breadboardinglabs/Breadboard8088PC/Docs/Datasheets/Video/IBM_PC_Original_Monochrome_Display_and_Parallel_Printer_Adapter.jpg

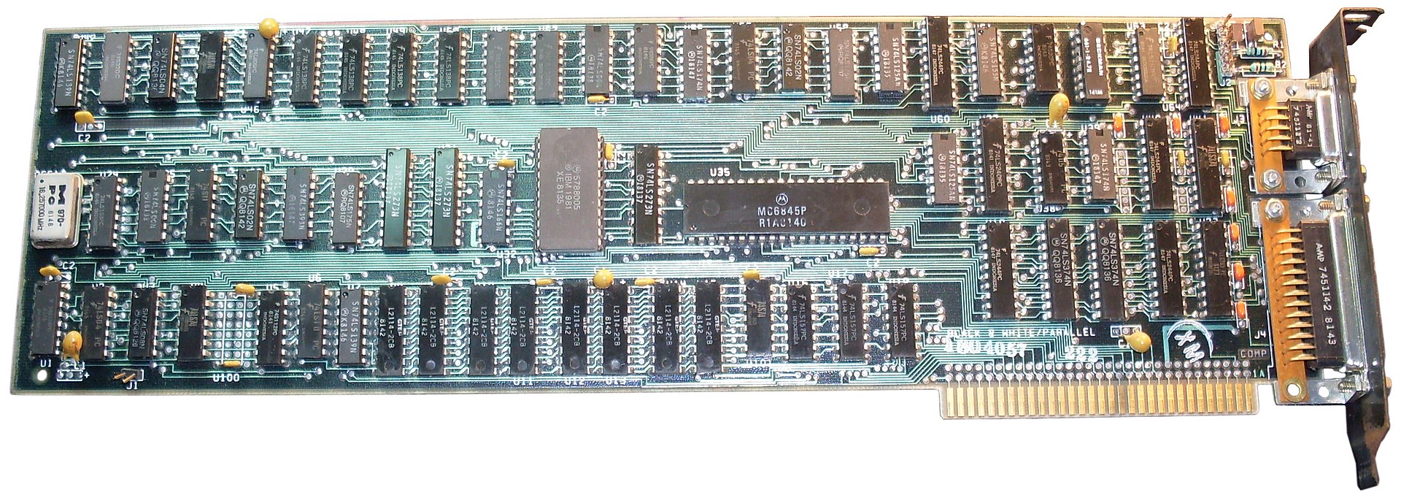
Docs/Datasheets/Video/IBM_PC_Original_Monochrome_Display_and_Parallel_Printer_Adapter.jpg
