breadboardinglabs/Breadboard8088PC/README.md

# Breadboard8088PC
IBM PC-XT Hybrid PC built on Breadboards
KiCad V2 for Breadboard PC now KiCad V8
Work in progress
