breadboardinglabs/Breadboard8088PC/Chiplabels/bbpc8088_p1v5.pdf

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
1̅C̅l̅r
1J
1̅K̅
1Clk
1̅P̅r̅e
1Q
1̅Q̅
GND

Vcc
2̅C̅l̅r
2J
2̅K̅
2Clk
2̅P̅r̅e
2Q
2̅Q̅

7
4
L
S
1
0
9

1̅C̅l̅r
1J
1̅K̅
1Clk
1̅P̅r̅e
1Q
1̅Q̅
GND

Vcc
2̅C̅l̅r
2J
2̅K̅
2Clk
2̅P̅r̅e
2Q
2̅Q̅

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
IRQA
IRQB
RS0
RS1
̅R̅E̅S̅E̅T
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
R/̅w̅

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
IRQA
IRQB
RS0
RS1
̅R̅E̅S̅E̅T
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
R/̅w̅

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
̅N̅M̅I̅
̅I̅R̅Q̅
̅F̅I̅R̅Q̅
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
H̅A̅L̅T̅
TSC
LIC
̅R̅E̅S̅E̅T
AVMA
Q
E
BUSY
R/̅W̅
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
C̅S̅
A10
PD/PGM
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
̅W̅E̅
A13
A8
A9
A11
̅O̅E̅
A10
̅C̅E̅
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
E (F)
F (E)
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
I/O0
I/O1
I/O2
Vss

Vcc
̅W̅E̅
A13
A8
A9
A11
̅O̅E̅
A10
̅C̅E̅
I/O7
I/O6
I/O5
I/O4
I/O3

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
R̅E̅S̅E̅T̅
LPSTB
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
MA10
MA11
MA12
MA13
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
̅C̅S̅
RS
E
R/̅W̅
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
I/O0
I/O1
I/O2
I/O3
I/O4
I/O5
VCC
I/O17
I/O16
I/O15
I/O14
I/O13
I/O12
In17
In18
In19
In20

In40
In39
In38
In37
I/O6
I/O7
I/O8
I/O9
I/O10
I/O11
GND
I/O23
I/O22
I/O21
I/O20
I/O19
I/O18
In23
In22
In21

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
DP 3
C 4
G 5
D4 6

12 D1
11 A
10 F
9 D2
8 D3
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
DP 3
C 4
G 5
D4 6

12 D1
11 A
10 F
9 D2
8 D3
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
P̅B̅R̅
TD
TOL
GND

Vcc
̅S̅T̅
̅R̅S̅T̅
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
̅G̅1̅
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
̅G̅2̅
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
̅G̅1̅
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
̅G̅2̅
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
̅G̅1̅
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
̅G̅2̅
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
̅G̅1̅
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
̅G̅2̅
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
CKI0
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
CKI0
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
II10
GND

Vcc
I/O0
I/O1
I/O2
I/O3
I/O4
I/O5
I/O6
I/O7
I/O8
I/O9
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
DCLK
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
̅Y̅0
̅Y̅1
̅Y̅2
̅Y̅3
̅Y̅4
̅Y̅5
Y0
̅Y̅7
vrw1
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
DCLK
SRO
CUR
DEIN
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
D̅E̅O
DE1
C̅L̅R
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
DCLK
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
DCLK
A0
NC
NC
NC
NC
VRW
R/W
̅Y̅0
Y0
DEin
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
D̅E̅O
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
̅1̅G̅
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
̅1̅G̅
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
̅1̅G̅
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
̅1̅G̅
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
8Vcc

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
25.175
MHz

1NC

GND

8Vcc

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
8Vcc

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
3.686
MHz

1NC

GND

8Vcc

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
1.843
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
C̅E̅L̅
R/̅W̅L̅
A11L
A10L
̅O̅E̅L̅
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
I/O0L
I/O1L
I/O2L
I/O3L
I/O4L
I/O5L
I/O6L
I/O7L
GND

Vcc
̅C̅E̅R̅
R/̅W̅R̅
A11R
A10R
̅O̅E̅R̅
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
I/O7R
I/O6R
I/O5R
I/O4R
I/O3R
I/O2R
I/O1R
I/O0R

I
D
T
7
1
3
4

C̅E̅L̅
R/̅W̅L̅
A11L
A10L
̅O̅E̅L̅
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
I/O0L
I/O1L
I/O2L
I/O3L
I/O4L
I/O5L
I/O6L
I/O7L
GND

Vcc
̅C̅E̅R̅
R/̅W̅R̅
A11R
A10R
̅O̅E̅R̅
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
I/O7R
I/O6R
I/O5R
I/O4R
I/O3R
I/O2R
I/O1R
I/O0R

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
I/O0
I/O1
I/O2
Vss

Vcc
̅W̅E
NC
A8
A9
A11
̅O̅E̅
A10
̅C̅E̅
I/O7
I/O6
I/O5
I/O4
I/O3

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
I/O0
I/O1
I/O2
Vss

Vcc
̅W̅E̅
A13
A8
A9
A11
̅O̅E̅
A10
̅C̅E̅
I/O7
I/O6
I/O5
I/O4
I/O3

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
̅W̅E̅
A13
A8
A9
A11
̅O̅E̅
A10
̅C̅E̅
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
̅W̅E̅
A13
A8
A9
A11
̅O̅E̅
A10
̅C̅E̅
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
I/O0
I/O1
I/O2
Vss

Vcc
̅W̅E
NC
A8
A9
A11
̅O̅E̅
A10
̅C̅E̅
I/O7
I/O6
I/O5
I/O4
I/O3

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
R0(1)
R0(2)

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
R0(1)
R0(2)

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
2I-2I+
1I-1I+

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
2I-2I+
1I-1I+

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
O̅C̅
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
O̅C̅
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
O̅C̅
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
̅G̅1̅
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
̅G̅2̅
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
̅G̅1̅
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
̅G̅2̅
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
̅G̅1̅
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
̅G̅2̅
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
̅G̅1̅
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
̅G̅2̅
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
Green
Blue
IRef
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
PCLK
Vss

Vdd
RS1
RS0
̅W̅R̅
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
̅B̅l̅a̅n̅k
̅R̅D̅

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
Green
Blue
IRef
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
PCLK
Vss

Vdd
RS1
RS0
̅W̅R̅
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
̅B̅l̅a̅n̅k
̅R̅D̅

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
G̅1̅E
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
G̅1̅E
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
G̅2̅E
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
G̅2̅E
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
C̅L̅R
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
C̅L̅R
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
QbCk
A0
MA12
GM1
GM0
PA1
VRW
R/W
̅Y̅0
Y0
DEin
GND

Vcc
̅G̅1̅E
̅G̅2̅E
DE1
CHR
̅H̅O̅E
̅H̅C̅E
̅O̅O̅E
COR
̅C̅C̅E
̅D̅E̅O
̅Y̅3̅C

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
QbCk
A0
MA13
GM1
GM0
PA1
VRW
R/W
̅Y̅0
Y0
DEin
GND

Vcc
̅G̅1̅E
̅G̅2̅E
DE1
CHR
̅H̅O̅E
̅H̅C̅E
̅O̅O̅E
COR
̅C̅C̅E
̅D̅E̅O
̅Y̅3̅C

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
̅O̅E̅

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
MA12
MA11
MA10
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
̅O̅E̅

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
̅O̅E̅

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
F/B̅

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
̅3̅I̅d̅e
R/̅W̅
NC
GND

Vcc
̅U̅d̅w
̅U̅d̅r
̅L̅d̅w
̅I̅o̅w
̅I̅o̅r
̅C̅S̅0
̅C̅S̅1
̅L̅d̅r
̅O̅E̅

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
̅ Q4
Q5
Q6
Q7
̅O̅E̅

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
CA13
CA12
CA11
CA10
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
̅O̅E̅

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
Edclk
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
mrdy
dc0
dc1
dc2
dc3
̅O̅E̅

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
DClk
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
!sY0
NC
NC
NC
NC
NC
̅O̅E̅

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
QbCk
A0
MA12
GM1
GM0
PA1
VRW
R/W
̅Y̅0
Y0
DEin
GND

Vcc
̅G̅1̅E
̅G̅2̅E
DE1
CHR
̅H̅O̅E
̅H̅C̅E
̅O̅O̅E
COR
̅C̅C̅E
̅D̅E̅O
̅Y̅3̅C

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
TEST0
XTAL1
XTAL2
̅R̅E̅S̅E̅T
THSS
CS
TLEA
RD
A0
WR
SYNC
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
TEST1
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
THSSP
THPR
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
IOB7
IOB6
IOB5
IOB4
IOB3
IOB2
IOB1
IOB0
IOA7
IOA6
IOA5
IOA4
IOA3
IOA2
IOA1

Vcc
TEST1
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
BDIR
TEST2
A8
̅A̅9̅
R̅E̅S̅E̅T
Clock
IOA0

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
ID10
ID11
ID12
ID13
ID14
ID15
KEY
GND
GND
GND
CSEL
GND
IOCS16
PDIAG
IA2
̅C̅S̅3̅F̅X
GND

I
D
E

1
3
9

R̅S̅T̅
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
DMARQ
̅I̅D̅W̅
̅I̅D̅R̅
IORDY
DMACK
IRQ
IA1
IA0
̅C̅S̅1̅F̅X
̅A̅C̅T̅I̅V̅E

In1
In2
In3
I/O0
I/O1
I/O2
I/O3
I/O4
I/O5
VCC
I/O17
I/O16
I/O15
I/O14
I/O13
I/O12
In17
In18
In19
In20

In40
In39
In38
In37
I/O6
I/O7
I/O8
I/O9
I/O10
I/O11
GND
I/O23
I/O22
I/O21
I/O20
I/O19
I/O18
In23
In22
In21

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
DotClk
E
R/W
Qa
Qb
Qc
Y0
I/O4
I/O5
VCC
I/O17
DC69
DC36
DC912
I/O13
I/O12
In17
In18
In19
In20

In40
In39
In38
In37
DCQ0
DCQ1
DCQ2
DCQ3
Y0
NotY0
GND
VRW
EQa
EQb
EQc
MRDY
I/O18
In23
In22
In21

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
# Nanocomp 6809 (for copying)
