breadboardinglabs/Breadboard8088PC/Chiplabels/bbpc8088v4.pdf

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
IRQA
IRQB
RS0
RS1
̅R̅E̅S̅E̅T
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
R/̅w̅

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
I/O0
I/O1
I/O2
Vss

Vcc
̅W̅E̅
A13
A8
A9
A11
̅O̅E̅
A10
̅C̅E̅
I/O7
I/O6
I/O5
I/O4
I/O3

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
CKI0
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
Out1
̅R̅s̅t
Spkr
Out2
I4
I5
I6
I7
I8
I9
̅T̅C̅
GND

Vcc
refd
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
̅R̅s̅t
̅I̅O̅R̅
̅I̅O̅W̅
I4
I5
̅L̅o̅c̅k
̅S̅0
̅S̅1
Hrq
Hold
GND

Vcc
̅D̅W̅
ABR
̅A̅E̅N
̅R̅D̅D
IO4
IO5
IO6
̅Rw1
Irwc
RD1
Rd̅w̅

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
I̅o̅1̅9
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
̅d̅p̅w̅
̅d̅m̅a
̅P̅i̅t
̅P̅i̅c̅1
̅P̅B̅r̅
̅P̅B̅w̅
̅P̅i̅c̅2
̅P̅o̅s̅t
̅I̅o̅w̅
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
8Vcc

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
3.686
MHz

C̅E̅L̅
R/̅W̅L̅
A11L
A10L
̅O̅E̅L̅
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
I/O0L
I/O1L
I/O2L
I/O3L
I/O4L
I/O5L
I/O6L
I/O7L
GND

Vcc
̅C̅E̅R̅
R/̅W̅R̅
A11R
A10R
̅O̅E̅R̅
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
I/O7R
I/O6R
I/O5R
I/O4R
I/O3R
I/O2R
I/O1R
I/O0R

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
̅W̅E̅
A13
A8
A9
A11
̅O̅E̅
A10
̅C̅E̅
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
I/O0
I/O1
I/O2
Vss

Vcc
̅W̅E
NC
A8
A9
A11
̅O̅E̅
A10
̅C̅E̅
I/O7
I/O6
I/O5
I/O4
I/O3

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
̅O̅E̅
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
̅O̅E̅
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
̅O̅E̅
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
̅G̅1̅
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
̅G̅2̅
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
̅G̅1̅
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
̅G̅2̅
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
Green
Blue
IRef
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
PCLK
Vss

Vdd
RS1
RS0
̅W̅R̅
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
̅B̅l̅a̅n̅k
̅R̅D̅

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
̅O̅E̅
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
M̅E̅M̅R̅
̅M̅E̅M̅W̅

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
̅I̅O̅R̅
̅I̅O̅W̅

E
̅R̅E̅S̅E̅T̅

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
INTR
CLK
GND

VCC
A15
A16S3
A17S4
A18S5
A19S6
HIGH
MN̅M̅X̅
̅R̅D̅
̅R̅Q̅G̅T̅0
̅R̅Q̅G̅T̅1
̅L̅O̅C̅K̅
̅S̅2̅
̅S̅1̅
̅S̅0̅
QS0
QS1
̅T̅E̅S̅T̅
READY
RESET

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
Csyc
Pclk
̅A̅e̅n̅1
Rdy1
Rdy
Rdy2
̅A̅e̅n̅2
CLK
GND

Vcc
X1
X2
̅A̅s̅y
EFI
F/̅C̅
Osc
̅R̅e̅s
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
̅S̅1̅
Dt/R̅
ALE
̅A̅E̅N
m̅r̅d
̅a̅m̅w
̅m̅wt
GND

Vcc
̅S̅0̅
̅S̅2̅
m̅p̅d
Den
Cen
̅I̅n̅t̅a
̅I̅o̅r̅c
̅A̅i̅ow
̅I̅o̅w

8
2
8
8

# Breadboard 8088 PC Ver 4.0

# Intel Chips

# 74 Series Logic Chips (0I indicate zero indexed)

# Memory Chips RAM & EEPROM

# PLD Programmable Logic Devices

# Other Chips and components

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
̅O̅E̅
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
̅O̅E̅
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
̅O̅E̅
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
P̅B̅R̅
TD
TOL
GND

Vcc
̅S̅T̅
̅R̅S̅T̅
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
8Vcc

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
1.843
MHz

1NC

GND

8Vcc

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
25.175
MHz

1NC

GND

8Vcc

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
8Vcc

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
14.3
MHz

̅I̅O̅R̅
̅I̅O̅W̅
̅M̅E̅M̅R
̅M̅EM̅w
Pin 5
Ready
HLDA
ADstb
AEN
HRQ
̅C̅S̅
CLK
RESET
Dack2
Dack3
Dreq3
Dreq2
Dreq1
Dreq0
GND

A7
A6
A5
A4
̅E̅O̅P̅
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
Dack0
Dack1
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
R̅E̅S̅E̅T̅
LPSTB
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
MA10
MA11
MA12
MA13
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
̅C̅S̅
RS
E
R/̅W̅
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
TEST0
XTAL1
XTAL2
̅R̅E̅S̅E̅T
THSS
CS
TLEA
RD
A0
WR
SYNC
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
TEST1
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
THSSP
THPR
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
̅W̅E̅
A13
A8
A9
A11
̅O̅E̅
A10
̅C̅E̅
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
̅W̅E̅
A13
A8
A9
A11
̅O̅E̅
A10
̅C̅E̅
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
̅W̅E̅
A13
A8
A9
A11
̅O̅E̅
A10
̅C̅E̅
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
̅R̅C̅L̅R̅
Vbat
̅I̅R̅Q̅
̅R̅E̅S̅E̅T̅
DS
GND
R/̅W̅
AS
̅C̅S̅

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
CLK0
OUT0
Gate0
GND

Vcc
̅W̅R̅
̅R̅D̅
̅C̅S̅
A1
A0
CLK2
OUT2
Gate2
CLK1
Gate1
OUT1

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
̅C̅S̅
̅W̅R̅
̅R̅D̅
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
CAS0
CAS1
GND

Vcc
A0
̅I̅N̅T̅A
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
̅S̅P/̅E̅N
CAS2

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
̅T̅x̅C̅
̅W̅R̅
̅C̅S̅
C/̅D̅
̅R̅D̅
RxRdy

D1
D0
Vcc
̅R̅x̅C
̅D̅T̅R
̅R̅T̅S
̅D̅S̅R
RESET
CLK
TxD
TxEmp
̅C̅T̅S
Syn/Bd
TxRdy

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
̅R̅D̅
̅C̅S̅
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
̅W̅R̅
RESET
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
̅M̅m̅r
̅M̅m̅w
DEN
GND

Vcc
IO0
IO1
IO2
̅C̅m̅0
̅P̅I̅A̅
̅R̅o̅m
̅R̅m̅1
E
̅R̅S̅T̅
̅D̅E̅N̅
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
DP 3
C 4
G 5
D4 6

12 D1
11 A
10 F
9 D2
8 D3
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
DP 3
C 4
G 5
D4 6

12 D1
11 A
10 F
9 D2
8 D3
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
VSin
HSin
InVS
InHS
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
̅O̅E̅

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
E (F)
F (E)
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
̅i̅o̅r
̅I̅o̅w̅
DEN
GND

Vcc
IO0
IOA
̅M̅d̅a
̅C̅m̅0
̅P̅I̅A̅
̅R̅o̅m
̅R̅m̅1
E
̅R̅S̅T̅
̅D̅E̅N̅
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
IO19
̅I̅O̅R
̅I̅O̅W̅
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
̅C̅r̅t̅s
̅6̅4̅5
̅C̅r̅t̅c
NC
̅P̅R̅D̅
̅P̅W̅R
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
25Mz
RA0
RA1
RA2
RA3
̅R̅S̅T
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
̅Q̅c̅
̅D̅o̅t
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
BlEn
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
Sdot
URA
BlEn
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
I0Clk
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
io19
io18
io17
io16
io15
io14
io13
io12
̅O̅E̅

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
PClk
Ck88
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
pitc
̅C̅L̅K̅
CLK
Clk3
Clk4
Clk5
̅R̅S̅T
̅O̅E̅

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
M̅R̅
Q0
̅Q̅0
D0
D1
̅Q̅1
Q1
GND

Vcc
Q3
̅Q̅3
D3
D2
̅Q̅2
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
̅M̅R
Hires
̅H̅i̅r̅e̅s
D0
D2
̅Q̅1
BW
GND

Vcc
EnBl
̅Q̅3
D5
D3
̅Q̅2
VEN
̅C̅r̅t̅c

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
̅G̅W̅
̅G̅R̅
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
25Mz
RA0
RA1
RA2
RA3
̅R̅S̅T
NC
NC
NC
NC
NC
GND

Vcc
Asrl
URA
VA0
CHL
Qa
Qb
CCc
̅Q̅c̅
vadl
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
M̅R̅
Q1
̅Q̅1
D1
D2
̅Q̅2
Q2
GND

Vcc
Q4
̅Q̅4
D4
D3
̅Q̅3
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
1̅C̅l̅r
1D
̅1̅C̅l̅k
̅1̅P̅R
1Q
̅1̅Q̅
GND

Vcc
̅2̅C̅l̅r
2D
̅2̅C̅l̅k
̅2̅P̅R̅
2Q
̅2̅Q̅

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
Irwc
IRD
̅R̅dw
Rd̅w̅
GND

Vcc
̅Hrq
RD1
̅C̅l̅k̅
̅2̅P̅R̅
Hold
̅2̅Q̅

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
BlEn
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
̅G̅/W

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
̅R̅D
̅W̅R̅
̅C̅S̅
A0
̅D̅A̅C̅K̅
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
̅L̅D̅O̅R̅
̅L̅D̅C̅R̅
RST
̅R̅D̅D̅

Vcc
̅I̅D̅X̅
̅T̅R̅0̅0̅
̅W̅P̅
̅R̅W̅C̅
̅H̅D̅L
̅M̅O̅2
̅M̅O̅1
̅D̅S̅2
VSS
̅D̅S̅1
̅S̅T̅E̅P
̅D̅I̅R̅C̅
̅W̅D̅
̅W̅E̅
̅H̅S̅
PCVAL
CLK1
DRV
CLK2

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
̅R̅s̅t
̅I̅O̅R̅
̅I̅O̅W̅
I4
I5
̅L̅o̅c̅k
̅S̅0
̅S̅1
Hrq
Hold
GND

Vcc
̅D̅W̅
ABR
̅A̅E̅N
̅R̅D̅D
AB1
Rdm
̅D̅e̅n̅
̅Rw1
Irwc
RD1
Rd̅w̅

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
Out1
̅R̅s̅t
Spkr
Out2
A0
A1
A2
I7
I8
̅F̅D̅C̅
̅T̅C̅
GND

Vcc
refd
IO1
IO2
IO3
IO4
̅L̅d̅c̅r
̅L̅d̅o̅r
̅F̅d̅c̅s
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
IO19
̅I̅O̅R
̅I̅O̅W̅
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
̅C̅r̅t̅s
̅6̅4̅5
̅C̅r̅t̅c
̅F̅D̅C̅
̅P̅R̅D̅
̅P̅W̅R
̅K̅e̅y̅
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
