breadboardinglabs/Breadboard8088PC/Chiplabels/bbpc8088v6_pg2.pdf

# Breadboard 8088 PC Ver 6.0

# CGA PLD Programmable Logic Devices

# CGA Snow Programmable Logic Devices

## Main IO Decoder V4

## CGA IO Decoder U69 V4

## CGA Blink Clock U58 V1

## CGA Logic PLD1 U82 V1

## CGA Logic PLD1 U82 V2

## CGA Logic PLD2 U81 V2

## CRTC ADD MUX 2 U76 V1 CGA COL MUX U59 V1

## CGA ATT Latch MUX U64 V1

## CGA Video Out U60 V1

CGA Clock U63 V1 | CGA Clock U63 V2
| 40 Column Mode

## CRTC ADD MUX 1 U77 V1

Id3
VS 14
HS 13
Id1
Id0
GndV
+5V 9
GndB
GndG
GndR
GndH
Id2 4
Blue 3
Green
Red 1

Id3
VS 14
HS 13
Id1
Id0
GndV
+5V 9
GndB
GndG
GndR
GndH
Id2 4
Blue 3
Green
Red 1

CKI0
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
Hires
NC
NC
NC
̅R̅S̅T
NC
NC
NC
NC
NC
GND

Vcc
AtSr
NC
̅CAt
ChL
Qa
Qb
Qc
Ccc
Cad
Dclk
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
Hires
640B
NC
NC
̅R̅S̅T
NC
NC
NC
NC
NC
GND

Vcc
AtSr
Qd
̅CAt
ChL
Qa
Qb
Qc
Ccc
Cad
Dclk
Grph

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
EnBl
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
AlDt
GND

Vcc
Grph
AT7
̅C̅S̅R
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
ColS
CBI
C0
C1
I
R
G
B
640B
NC
Grph
GND

Vcc
CRB
CRG
CRR
C1z
AlDt
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
VSin
HSin
InVS
InHS
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
̅O̅E̅

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
̅Io̅r
̅I̅o̅w̅
DEN
GND

Vcc
̅C̅g̅a̅
̅I̅O̅A̅
̅M̅d̅a
̅C̅m̅0
̅P̅I̅A̅
̅R̅o̅m
̅R̅m̅1
E
NC
̅D̅E̅N̅
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
## Main IO Decoder V5

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
̅Io̅r
̅I̅o̅w̅
DEN
GND

Vcc
̅C̅g̅a̅
̅I̅O̅A̅
̅M̅d̅a
̅C̅m̅0
̅P̅I̅A̅
̅R̅o̅m
̅R̅m̅1
E
ALE
̅D̅E̅N̅
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
BlEn
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
Sdot
B/̅D̅E
BlEn
NC
NC
̅R̅S̅T
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
Bd̅1̅
Cgt
̅C̅S̅R
AlDt
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
I0Clk
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
io19
io18
io17
io16
io15
io14
io13
io12
̅O̅E̅

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
Grph
Ma12
Ma11
Ma10
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
̅O̅E̅

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
C̅h̅At
Grph
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
̅O̅E̅

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
C̅r̅a̅m
̅C̅I̅O̅
̅I̅O̅R̅
̅I̅O̅W̅
̅M̅m̅r
̅M̅m̅W
NC
NC
640b
GND

Vcc
NC
̅A̅O̅E
̅A̅L̅E
̅V̅O̅E
̅6̅4̅o
̅C̅O̅E
DIR
̅2̅C̅E̅
̅O̅E̅

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
̅C̅I̅O̅
̅I̅O̅R̅
̅I̅O̅W̅
̅M̅m̅r
̅M̅m̅W
C̅r̅a̅m
NC
640b
GND

Vcc
NC
̅A̅O̅E
̅A̅L̅E
̅V̅O̅E
̅6̅4̅o
̅C̅O̅E
DIR
̅2̅C̅E̅
̅O̅E̅

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
̅6̅4̅oe
SBA
CBA
CAB
SAB
DIR
̅V̅r̅w
̅V̅r̅o̅e
̅O̅E̅

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
̅I̅O̅W
̅I̅O̅R
̅M̅m̅w
̅M̅m̅r
̅C̅r̅a̅m
GND

## CGA Logic PLD2 U81 V1

Vcc
̅O̅E
SBA
CBA
CAB
SAB
DIR
̅V̅r̅w
̅V̅r̅o̅e
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
̅I̅O̅W
̅I̅O̅R
̅M̅m̅w
̅M̅m̅r
̅C̅r̅a̅m
GND

## CGA Logic PLD2 U81 V5

Vcc
Asw
Cad
Rad
Clk2
Awe
CAB
Rda
Cat
Rw
Rw1
Grph

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
Hires
DClk
NC
̅M̅m̅w
̅M̅m̅r
̅C̅r̅a̅m
GND

## CGA Logic PLD3 U84 V2

Vcc
Dird
ACK
̅A̅do̅e
̅V̅o̅e
CBA
Cad
̅6̅4̅oe
DIR
̅V̅r̅w
̅V̅r̅o̅e
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
Cabd
Awe
̅M̅m̅w
̅M̅m̅r
̅C̅r̅a̅m
GND

IO19
̅I̅O̅R
̅I̅O̅W̅
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
̅C̅s̅t̅a
̅6̅4̅5
̅C̅c̅t̅l
̅C̅c̅o̅l
̅P̅R̅D̅
̅P̅W̅R
̅C̅I̅O̅
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
̅O̅E̅
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
̅O̅E̅
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
74ALS573 0 Index Rev. | 74ALS541 0 Index Rev. | 74ALS574 0 Index Rev. | 74ALS174 0 Index

̅G̅1̅
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
̅G̅2̅
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
̅G̅1̅
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
̅G̅2̅
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
̅O̅E̅
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
̅O̅E̅
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
̅O̅E̅
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
M̅R̅
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
M̅R̅
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
## CGA Logic PLD1 U82 V3

NC
̅C̅I̅O̅
̅I̅O̅R̅
̅I̅O̅W̅
̅M̅m̅r
̅M̅m̅W
C̅r̅a̅m
NC
640b
GND

Vcc
NC
NC
NC
NC
̅6̅4̅o
̅C̅O̅E
DIR
̅2̅C̅E̅
̅O̅E̅

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
## CGA Logic PLD2 U81 V11

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
̅V̅r̅o̅e
̅V̅a̅o̅e
̅6̅4̅o̅e
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
DClk
̅V̅r̅w̅e
̅A̅d̅o̅e
̅M̅m̅w
̅M̅m̅r
̅C̅r̅a̅m
GND

## CGA Logic PLD3 U84 V13

Vcc
Dc0
Dc1
CAB
̅C̅B̅A
̅A̅d̅o
̅V̅r̅w
Rdw
ACk
Dc2
Dc3
̅C̅r̅m

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
640b
Hires
Grph
Dir
Cas1
NC
̅M̅m̅r
GND

CKI0
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
xnor
xor
nor
or
nand
and
invb
inva
̅O̅E̅

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
CKI0
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
̅R̅D̅
̅W̅R̅
MI̅O̅
Rdy
̅A̅e̅n
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
̅C̅8̅8
̅M̅W̅
̅M̅R̅
̅I̅O̅W̅
̅I̅O̅R̅
Pclk
̅R̅s̅t
Rst
̅R̅E̅S

A
T
F
7
5
0
C
