breadboardinglabs/Breadboard8088PC/Docs/MDA_PLD_Design.xlsx

Sheet: Sheet1
MDA PLD Configuration | Clock PLD | Video PLD | Attribute | Blink VS HS
Inputs
CRTC
Cursor +1/2 Char Clk |  | I
Disp En +1/2 Char Clk |  | I
RA0 | I
RA1 | I
RA2 | I
RA3 | I
VS (+ve 70Hz) |  |  |  | I
HS (-ve 70Hz) |  |  |  | I
DotClock | I
/Reset | I | I
Attribute 0-7 (Blink/BI, BR, BG, BB, FI, FR, FG, FB) Underline 001 |  |  | I8
Control Port
Blink Enable |  | I
Video Enable |  | I
BW/Colour |  |  | I
Blink Clock
 |  | I
Outputs
VS |  |  |  | O
/HS |  |  |  | O
Blink Clock (VS/32) |  |  |  | O5
DotClk Buff | O
/DotClk | O
Qa | O
Qb | O
Qc Char Clk | O
/Qc Char Clk | O
Char Latch | O
SR Latch | O
Underline RA | O | I
Underline 001 |  | I | O
Video
Video B/W (Fore/Back) |  | O | I
Video Intensity |  | O
I |  |  | O
Red |  |  | O
Green |  |  | O
Blue |  |  | O
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
