breadboardinglabs/Breadboard8088PC/Docs/MappingDA_Combined_CGA.xlsx

Sheet: SNOW V2
CPU Start Activity Dot Clock Cycle | CAB ADCLK Start | CAB ADCLK End | OE Start | OE End | VRWE /CBA Start/End | Group
C0/4 | 2 | 2 | 4 | 5.5 | 5 | A
C1/5 | 2 | 2 | 3 | 4.5 | 4 | B | Mode 4 5-7.5
C2/6 | 2 | 2 | 6 | 7.5 | 7 | C
C3/7 | 2 | 2 | 4 | 5.5 | 5 | D
C4 | 3 | 3 | 5.5 | 7 | 6 | A
C5 | 3 | 3 | 4.5 | 6 | 5 | B
C6 | 3 | 3 | 7.5 | 9 | 8 | C
C7 | 3 | 3 | 6.5 | 8 | 7 | D
Count Dot Clock (DC) Cycles from MEMR/MEMW signal high to low transition (CPUACT CPU Activity) |  |  |  |  | NOTE | VRWE 1/2 Dot Clock Wide 20ns
Zero Dot Clock Cycle count when CPUACT=0 |  |  |  |  |  | OE End really means previous cycle 7 end all of 6!
 |  |  |  |  |  | OE Starts are on 2nd half of Dot Clock when low !DotClk
Qa,Qb,Qc CRTC clocks latched by rising CPUACT to CQa, CQb, CQc, CQd Clock=CPUACT, .d=Qa/Qb/Qc/Qd |  |  |  |  | OE | ADOE, VROE, VAOE, 646OE
DotClock Q0,Q1,Q2,Q3, clocked by CPUACT & Dot Clock (only clock when CPUACT high), cleared by CPUACT low |  |  |  |  |  | 646OE when reading is same period as MEMR

Sheet: SNOW V1
CPU Start Activity Dot Clock Cycle | CAB ADCLK Start | CAB ADCLK End | OE Start | OE End | VRWE /CBA Start/End | Group
C0 | 3 | 3 | 5.5 | 7 | 6 | A
C1 | 3 | 3 | 4.5 | 6 | 5 | B
C2 | 3 | 3 | 7.5 | 9 | 8 | C
C3 | 3 | 3 | 6.5 | 8 | 7 | D
C4 | 3 | 3 | 5.5 | 7 | 6 | A
C5 | 3 | 3 | 4.5 | 6 | 5 | B
C6 | 3 | 3 | 7.5 | 9 | 8 | C
C7 | 3 | 3 | 6.5 | 8 | 7 | D
Count Dot Clock (DC) Cycles from MEMR/MEMW signal high to low transition (CPUACT CPU Activity) |  |  |  |  | NOTE | VRWE 1/2 Dot Clock Wide 20ns
Zero Dot Clock Cycle count when CPUACT=0 |  |  |  |  |  | OE End really means previous cycle 7 end all of 6!
 |  |  |  |  |  | OE Starts are on 2nd half of Dot Clock when low !DotClk
Qa,Qb,Qc CRTC clocks latched by rising CPUACT to CQa, CQb, CQc, CQd Clock=CPUACT, .d=Qa/Qb/Qc/Qd |  |  |  |  | OE | ADOE, VROE, VAOE, 646OE
DotClock Q0,Q1,Q2,Q3, clocked by CPUACT & Dot Clock (only clock when CPUACT high), cleared by CPUACT low |  |  |  |  |  | 646OE when reading is same period as MEMR

Sheet: Sheet2
Dot Clock Cycle | Width | C0 Start | C0 End | C1 Start | C1 End | C2 Start | C2 End | C3 Start | C3 End | C4 Start | C4 End | C5 Start | C5 End | C6 Start | C6 End | C7 Start | C7 End
CharLatch | 36 | 0 | 0 | 8 | 8 | 8 | 8 | 8 | 8 | 8 | 8 | 8 | 8 | 8 | 8 | 0 | 0
AtSRLatch | 36 | 4 | 4 | 4 | 4 | 4 | 4 | 4 | 4 | C | C | 4 | 4 | C | C | 4 | 4
CAB | 68 | 3 | 4 | 3.5 | 5.5 | 4.5 | 6.5 | A | B | 7.5 | 9.5 | D.5 | F.5 | 9.5 | B.5 | 6 | 7
/CBA | 52 | A | A
646Dir | 32 | A | B | 12 | 12 | 12 | 12 | 12 | 12 | 12 | 12 | A.5 | B.5 | 12 | 12 | A | A
646OE | 26 | A | B | 12 | 12 | 12 | 12 | 12 | 12 | 12 | 12 | A.5 | B.5 | 12 | 12 | A | A
/VROE | 32 | A | B | 12 | 12 | 12 | 12 | 12 | 12 | 12 | 12 | A.5 | B.5 | 12 | 12 | A | A
VRWE | 16 | A | B | 12 | 12 | 12 | 12 | 12 | 12 | 12 | 12 | A.5 | B.5 | 12 | 12 | A | A
/VAOE | 30 | A | B | 12 | 12 | 12 | 12 | 12 | 12 | 12 | 12 | A.5 | B.5 | 12 | 12 | A | A
/ADOE | 26 | A | B | 12 | 12 | 12 | 12 | 12 | 12 | 12 | 12 | A.5 | B.5 | 12 | 12 | A | A
ADCLK | 66 | 3 | 4 | 4 | 5 | 5 | 6 | A.5 | B.5 | 7.5 | 9.5 | D.5 | F.5 | 9.5 | B.5 | 6 | 7

Sheet: CGA PLDS
 | CPU | CRTC | CPU | CRTC | CPU | CRTC
VRAM Address | Char | Char | 2 Colour | 2 Colour | 4 Colour | 4 Colour | Outputs | CGA PLD1 | Outputs | CGA PLD2
VA0 | CA0 | Qc | CA0 | MA0 | CA0 | MA0 | VA0 | Qc/ChAt | VA7 | MA6
VA1 | CA1 | MA0 | CA1 | MA1 | CA1 | MA1 | VA1 | MA0 | VA8 | MA7
VA2 | CA2 | MA1 | CA2 | MA2 | CA2 | MA2 | VA2 | MA1 | VA9 | MA8
VA3 | CA3 | MA2 | CA3 | MA3 | CA3 | MA3 | VA3 | MA2 | VA10 | MA9
VA4 | CA4 | MA3 | CA4 | MA4 | CA4 | MA4 | VA4 | MA3 | VA11 | MA10
VA5 | CA5 | MA4 | CA5 | MA5 | CA5 | MA5 | VA5 | MA4 | VA12 | MA11
VA6 | CA6 | MA5 | CA6 | MA6 | CA6 | MA6 | VA6 | MA5 | VA13 | MA12
VA7 | CA7 | MA6 | CA7 | MA7 | CA7 | MA7 |  | MA6 | VA14 | RA1
VA8 | CA8 | MA7 | CA8 | MA8 | CA8 | MA8 |  | GRPH |  | 0
VA9 | CA9 | MA8 | CA9 | MA9 | CA9 | MA9 |  | OE |  | GRPH | Video Mode/GRPH
VA10 | CA10 | MA9 | CA10 | MA10 | CA10 | MA10 |  |  |  | OE
VA11 | CA11 | MA10 | CA11 | MA11 | CA11 | MA11
VA12 | CA12 | MA11 | CA12 | MA12 | CA12 | MA12
VA13 | CA13 | MA12 | CA13 | RA1 | CA13 | RA1
VA14 | 0 | 0 | 0 | 0 | 0 | 0

Sheet: CGA 40x25
Clock Cycle 80ns | 0 | 0 | 1 | 1 | 2 | 2 | 3 | 3 | 4 | 4 | 5 | 5 | 6 | 6 | 7 | 7
Dot Clock | 1 | 0 | 1 | 0 | 1 | 0 | 1 | 0 | 1 | 0 | 1 | 0 | 1 | 0 | 1 | 0
Qb | 0 | 0 | 1 | 1 | 0 | 0 | 1 | 1 | 0 | 0 | 1 | 1 | 0 | 0 | 1 | 1
Qc | 0 | 0 | 0 | 0 | 1 | 1 | 1 | 1 | 0 | 0 | 0 | 0 | 1 | 1 | 1 | 1
Qd | 0 | 0 | 0 | 0 | 0 | 0 | 0 | 0 | 1 | 1 | 1 | 1 | 1 | 1 | 1 | 1
/Char Attribute VA0 current | 0 | 0 | 1 | 1 | 1 | 1 | 1 | 1 | 1 | 1 | 0 | 0 | 0 | 0 | 0 | 0
/Char Clock | 1 | 1 | 1 | 1 | 1 | 1 | 1 | 1 | 0 | 0 | 0 | 0 | 0 | 0 | 0 | 0
Required VA0 | 0 | 0 | 0 | 0 | 1 | 1 | 1 | 1 | 1 | 1 | 1 | 1 | 0 | 0 | 0 | 0
ChAt currently !Qd + 80ns, needs to be + 160ns |  |  | (Qb & !Qc & !Qd) |  | # (!Qb & Qc & !Qb) |  | #(Qb & Qc &!Qd) |  | #(!Qb & !Qc& Qd)
Address | 0F0 | F1 | F2 | F3 | F4 | F5 | F6 | F7 | F8 | F9
VA0 | 0 | 1 | 0 | 1 | 0 | 1 | 0 | 1 | 0 | 1
VA1 | 0 | 0 | 1 | 1 | 0 | 0 | 1 | 1 | 0 | 0
VA2 | 0 | 0 | 0 | 0 | 1 | 1 | 1 | 1 | 0 | 0
Real VA0
Real VA1 |  | 1
 | 0 | 4 | space | 0 | 8 | Symbol 1 | space | 0 | 9 | symbol 2
Attribute | 0F | 0F | 0F | 08 | 08 | 08 | 0F | 09 | 09 | 09
Observed | 0F | 08 | ? | 09 | 08 | 09 | 7 & 09 | 0A | 09 | 0A

Sheet: MCGA 640x480 x 2C
Video RAM 1 | CPU | CRTC | Video RAM 2 | CPU | CRTC | Character RAM 4K | CPU | CRTC |  | Page/Graphics Mode Register
Graphics1 |  |  | Graphics2 |  |  |  |  |  | Bit |  |  | Page 0 - 16K | Page 1 16-32K | Page 2 32-48K | Page 3 48-64K
V1A0 | CA0 | MA0 | V2A0 | CA0 | MA0 | CHA0 | CA0 | RA0 | 0 | PA0 | Page LSB | 0 | 1 | 0 | 1
V1A1 | CA1 | MA1 | V2A1 | CA1 | MA1 | CHA1 | CA1 | RA1 | 1 | PA1 | Page MSB | 0 | 0 | 1 | 1
V1A2 | CA2 | MA2 | V2A2 | CA2 | MA2 | CHA2 | CA2 | RA2
V1A3 | CA3 | MA3 | V2A3 | CA3 | MA3 | CHA3 | CA3 | RA3
V1A4 | CA4 | MA4 | V2A4 | CA4 | MA4 | CHA4 | CA4 | V1D0 | 2 | GM0 | 0=640x480 2 Colour, 1=320x200 256 Colour
V1A5 | CA5 | MA5 | V2A5 | CA5 | MA5 | CHA5 | CA5 | V1D1 | 3 | GM1 | Graphics=1 Character=0
V1A6 | CA6 | MA6 | V2A6 | CA6 | MA6 | CHA6 | CA6 | V1D2
V1A7 | CA7 | MA7 | V2A7 | CA7 | MA7 | CHA7 | CA7 | V1D3 | 4 | TBD | RAM or ROM Bank? |  | Block | CRTC Start | CRTC End | CPU Start | CPU End | Diff Start | Diff End
V1A8 | CA8 | MA8 | V2A8 | CA8 | MA8 | CHA8 | CA8 | V1D4 | 5 | TBD |  |  | 0 | 0 | 7999 | 0 | 7999
V1A9 | CA9 | MA9 | V2A9 | CA9 | MA9 | CHA9 | CA9 | V1D5 | 6 | TBD |  |  | 1 | 8192 | 16191 | 8000 | 15999 | 192 | 192
V1A10 | CA10 | MA10 | V2A10 | CA10 | MA10 | CHA10 | CA10 | V1D6 | 7 | TBD |  |  | 2 | 16384 | 24383 | 16000 | 23999 | 384 | 384
V1A11 | CA11 | MA11 | V2A11 | CA11 | MA11 | CHA11 | CA11 | V1D7 |  |  |  |  | 3 | 24576 | 32575 | 24000 | 31999 | 576 | 576
V1A12 | CA12 | MA12 | V2A12 | CA12 | MA12 | CE | 1 |  |  |  |  |  | 4 | 32768 | 40767 | 32000 | 39999 | 768 | 768
V1A13 | CA13 | RA0 | V2A13 | CA13 | RA0 | R/W | R/W |  |  |  |  |  | 5 | 40960 | 48959 | 40000 | 47999 | 960 | 960
V1A14 | CA14 | RA1 | V2A14 | CA14 | RA1 | CHD0 | D0 | SR_A |  |  |  |  | 6 | 49152 | 57151 | 48000 | 55999 | 1152 | 1152
1/OE (CHOE) | CA15 | RA2 | 2/OE (COOE) | CA15 | RA2 | CHD1 | D1 | SR_B |  |  |  |  | 7 | 57344 | 65343 | 56000 | 63999 | 1344 | 1344
CHR/W |  | 1 | COR/W |  | 1 | CHD2 | D2 | SR_C
V1D0 | D0 | SR_A | V2D0 | D0 | SR_A | CHD3 | D3 | SR_D
V1D1 | D1 | SR_B | V2D1 | D1 | SR_B | CHD4 | D4 | SR_E
V1D2 | D2 | SR_C | V2D2 | D2 | SR_C | CHD5 | D5 | SR_F |  |  |  |  |  |  | EEProM 8 bits |  | 64 - 6 bits
V1D3 | D3 | SR_D | V2D3 | D3 | SR_D | CHD6 | D6 | SR_G
V1D4 | D4 | SR_E | V2D4 | D4 | SR_E | CHD7 | D7 | SR_H
V1D5 | D5 | SR_F | V2D5 | D5 | SR_F
V1D6 | D6 | SR_G | V2D6 | D6 | SR_G | Outputs from VRAM 1 & 2 Latched with new D Latch and joined to Shift Register Inputs SR_A-SR_H
V1D7 | D7 | SR_H | V2D7 | D7 | SR_H
V1A# | Video RAM 1 Address |  |  |  | VRAM 1 32K Used in 16K 8000-BFFF 16K RANGE, A13=CA13 & A14=PA0
V1D# | Video RAM 1 Data |  |  |  | VRAM 2 32K Used in 16K 8000-BFFF 16K RANGE, A13=CA13 & A14=PA0
V2A# | Video RAM 2 Address
V2D# | Video RAM 2 Data |  |  |  | CRTC 80 Cols X 120 Rows x 4 Lines Per Character
CHA# | Character RAM Address
CHD# | Character RAM Data
MA# | CRTC Memory Address
RA# | CRTC Row Address
SR_# | Shift Register Data
CA# | CPU Address
D# | CPU Data
CL# | Colour Latch
PA# | Page Address

Sheet: CGA VRWE
CLK88 | 1 | 0 | 1 | 0 | 1 | 0 | 1 | 0 | 1 | 0 | 1 | 0 | 1 | 0
!CLK88 | 0 | 1 | 0 | 1 | 0 | 1 | 0 | 1 | 0 | 1 | 0 | 1 | 0 | 1
CGARAM | 0 | 0 | 1 | 1 | 1 | 1 | 1 | 1 | 0 | 0 | 0 | 0 | 0 | 0
MEMW | 0 | 0 | 0 | 1 | 1 | 1 | 1 | 0 | 0 | 0 | 0 | 0 | 0 | 0
MEMW & CGARAM | 0 | 0 | 0 | 1 | 1 | 1 | 1 | 0 | 0 | 0 | 0 | 0 | 0 | 0
VRWEDELAY | 0 | 0 | 0 | 0 | 0 | 1 | 1 | 1 | 1 | 0 | 0 | 0 | 0 | 0
VRWE=VRWEDELAY & MEMW & CLK88 | 0 | 0 | 0 | 0 | 0 | 1 | 1 | 0 | 0 | 0 | 0 | 0 | 0 | 0

Sheet: COMBINED PLD
Inputs | Outputs | Rules
NANOCOMPV11.PLD | Nanocomp Address Decoder
Pin 1 = DotClk; | Pin 23 = !Y0VRAM; /* Video RAM Low */ | Y0VRAM = (A15 & !A14) & E;
Pin 2 = RW; | Pin 22 = !Y1RAM; /* RAM /CS */ | Y1RAM = !A15 & E;
Pin 3 = A15; | Pin 21 = !Y2CRAM; /* Video Character RAM */ | Y2CRAM = A15 & A14 & !A13 & !A12 & E;
Pin 4 = A14; | Pin 20 = !Y3CRTC; /* CRTC */ | Y3CRTC = A15 & A14 & !A13 & A12 & !A11 & A10 & E; /* take out A8 and A9 conditions now that 74LS138 is used in place of Y6 */
Pin 5 = A13; | Pin 19 = !Y4PIA1; /* PIA MC6821 /CS */ | Y4PIA1 = A15 & A14 & !A13 & A12 & !A11 & !A10 & !A9 & !A8 & E;
Pin 6 = A12; | Pin 18 = !Y5SERIAL1; /* MC6850 /CS */ | Y5SERIAL1 = A15 & A14 & !A13 & A12 & !A11 & !A10 & A9 & !A8 & E;
Pin 7 = A11; | Pin 17 = Y0VRAMH; /* Video RAM High */ | Y0VRAMH = Y0VRAM;
Pin 8 = A10; | Pin 16 = !Y7ROM; /* ROM /CS */ | Y7ROM = A15 & A14 & A13 & E & RW;
Pin 9 = A9; | Pin 15 = VRAMRW1; /* Video RAM R/W shortened by Q&E */ | VRAMRW1.d = (RW # !Y0VRAMCE);
Pin 10 = A8; | Pin 14 = VRAMRW; /* Video RAM R/W ORd with !Y0VRAMCE */ | VRAMRW.d = VRAMRW1;
Pin 11 = Q;
Pin 13 = E; |  | Y0VRAMCE = (A15 & !A14) & E & Q;
VIDEOLOGIC1V12.PLD | Video Logic 1
Pin 1 = QbClk; | Pin 23 = !G1EN; /* Graphics Latch 1 Enable, sends VRAM data to Shift Reg */ | G1EN = (NOTY0 & !MA12 & (graphics_mode:2 # graphics_mode:3));
Pin 2 = A0; | Pin 22 = !G2EN; /* Graphics Latch 2 Enable, sends VRAM data to Shift Reg */ | G2EN = (NOTY0 & MA12 & (graphics_mode:2 # graphics_mode:3));
Pin 3 = MA12; | Pin 21 = DE1; /* Intermediate DE 1 clock delay, not used now */
Pin 4 = GM1; | Pin 20 = !CHRW; /* Character RAM Read/Write control */ | CHRW = ((!VRW & A0 & graphics_mode:0) # (!VRW & !PA1 & (graphics_mode:2 # graphics_mode:3)));
Pin 5 = GM0; | Pin 19 = !CHOE; /* Character RAM Output Enable control */ | CHOE = (((!CHRW # RW) & graphics_mode:0) # ((!(!VRW & !PA1) # (RW & !MA12)) & (graphics_mode:2 # graphics_mode:3)) );
Pin 6 = PA1; | Pin 18 = !CH245CE; /* Character 245 Buffer Chip Enable */ | CH245CE = ((Y0 & A0 & graphics_mode:0) # (Y0 & !PA1 & (graphics_mode:2 # graphics_mode:3)));
Pin 7 = VRW; | Pin 17 = !COOE; /* Colour RAM Output Enable control */ | COOE = (((!CORW # RW) & graphics_mode:0) # ((!(!VRW & PA1) # (RW & MA12)) & COLY3 & (graphics_mode:2 # graphics_mode:3)) );
Pin 8 = RW; | Pin 16 = !CORW; /* Colour RAM Read/Write control */ | CORW = ((!VRW & !A0 & graphics_mode:0) # (!VRW & PA1 & (graphics_mode:2 # graphics_mode:3)));
Pin 9 = NOTY0; | Pin 15 = !CO245CE; /* Colour 245 Buffer Chip Enable */ | CO245CE = ((Y0 & !A0 & graphics_mode:0) # (Y0 & PA1 & (graphics_mode:2 # graphics_mode:3)) # ( !COLY3 & graphics_mode:2));
Pin 10 = Y0; | Pin 14 = DEout; /* DE Inverted and delayed by 4 dot clock delays */ | DEout.d=!DEin;
Pin 11 = DEin;
Pin 13 = COLY3;
VIDEOLOGIC2V9.PLD | Video Logic 2
Pin 1 = DotClk; | Pin 23 = ForeBack; /* Video bit stream for foreground/background */ | ForeBack = Cur2 $ SRDotOut; /* Cursor delayed by 2 Dot Clocks XOR with Shift Register DotOut */
Pin 2 = SRDotOut; | Pin 22 = Cur1; /* Cursor delayed by 1 dot clock */ | Cur1.d = Cursor; /* Map Cursor to input of Cur1 Flip Flop */
Pin 3 = Cursor; | Pin 21 = Cur2; /* Cursor delayed by 2 dot clocks */ | Cur2.d = Cur1; /* Map Cur1 output to input of Cur2 Flip Flop to delay cursor by 2 dot clocks */
Pin 4 = NC0; | Pin 20 = CHLatch; /* Character Latch after 2 dot clock cycles */ | CHLatch=Qc # (!(Qa & Qb)); | Low to High 74LS574 trigger for latch
Pin 5 = NC1; | Pin 19 = Qa; /* Counter output /2 */ | Qa.d = !Qa;
Pin 6 = NC2; | Pin 18 = Qb; /* Counter outut /4 */ | Qb.d = (!Qb & Qa # Qb & !Qa);
Pin 7 = NC3; | Pin 17 = Qc; /* Counter output /8 */ | Qc.d = ((!Qc & Qb & Qa) # (Qc & !(Qb & Qa))) ;
Pin 8 = InvHS; | Pin 16 = SRLatch; /* Original /CLR delayed by 4 dot clock cycles */ | SRLatch= !(Qa & !Qb & Qc);
Pin 9 = InvVS; | Pin 15 = HSout; /* Horizontal Sync, inverted if InvHS is true */ | HSout=HSin&!InvHS # !HSin&InvHS;
Pin 10 = HSin; | Pin 14 = VSout; /* Vertical Sync, inverted if InvVS is true */ | VSout=VSin&!InvVS # !VSin&InvVS;
Pin 11 = VSin;
Pin 13 = NC4;
VRAM CRTC address 1
Pin 1 = MA6 | Pin 23 = VA6 | VA6 = (MA6 & (graphics_mode:0)) # (MA3 & (graphics_mode:2 # graphics_mode:3));
Pin 2 = MA5 | Pin 22 = VA5 | VA5 = (MA5 & (graphics_mode:0)) # (MA2 & (graphics_mode:2 # graphics_mode:3));
Pin 3 = MA4 | Pin 21 = VA4 | VA4 = (MA4 & (graphics_mode:0)) # (MA1 & (graphics_mode:2 # graphics_mode:3));
Pin 4 = MA3 | Pin 20 = VA3 | VA3 = (MA3 & (graphics_mode:0)) # (MA0 & (graphics_mode:2 # graphics_mode:3));
Pin 5 = MA2 | Pin 19 = VA2 | VA2 = (MA2 & (graphics_mode:0)) # (RA2 & (graphics_mode:2)) # (RA1 & (graphics_mode:3));
Pin 6 = MA1 | Pin 18 = VA1 | VA1 = (MA1 & (graphics_mode:0)) # (RA1 & (graphics_mode:2)) # (Qc & (graphics_mode:3));
Pin 7 = MA0 | Pin 17 = VA0 | VA0 = (MA1 & (graphics_mode:0)) # (RA0 & (graphics_mode:2)) # (Qb & (graphics_mode:3));
Pin 8 = RA2 | Pin 16 = Qb
Pin 9 = RA1 | Pin 15 = GM1 | [VA0..VA6].OE = !OEN; /* Outputs enabled when OE Low */
Pin 10 = RA0 | Pin 14 = GM0
Pin 11 = Qc |  | field graphics_mode = [GM1,GM0];
Pin 13 = OE
VRAM CRTC address 2
Pin 1 = MA12 | Pin 23 = VA14 | VA14 = (PA1 & (graphics_mode:0)) # (MA11 & (graphics_mode:2 # graphics_mode:3));
Pin 2 = MA11 | Pin 22 = VA13 | VA13 = (PA0 & (graphics_mode:0)) # (MA10 & (graphics_mode:2 # graphics_mode:3));
Pin 3 = MA10 | Pin 21 = VA12 | VA12 = (MA13 & (graphics_mode:0)) # (MA9 & (graphics_mode:2 # graphics_mode:3));
Pin 4 = MA9 | Pin 20 = VA11 | VA11 = (MA12 & (graphics_mode:0)) # (MA8 & (graphics_mode:2 # graphics_mode:3));
Pin 5 = MA8 | Pin 19 = VA10 | VA10 = (MA11 & (graphics_mode:0)) # (MA7 & (graphics_mode:2 # graphics_mode:3));
Pin 6 = MA7 | Pin 18 = VA9 | VA9 = (MA10 & (graphics_mode:0)) # (MA6 & (graphics_mode:2 # graphics_mode:3));
Pin 7 = MA6 | Pin 17 = VA8 | VA8 = (MA9 & (graphics_mode:0)) # (MA5 & (graphics_mode:2 # graphics_mode:3));
Pin 8 = MA5 | Pin 16 = VA7 | VA7 = (MA8 & (graphics_mode:0)) # (MA4 & (graphics_mode:2 # graphics_mode:3));
Pin 9 = MA4 | Pin 15 = GM1
Pin 10 = PA1 | Pin 14 = GM0 | [VA7..VA14].OE = !OEN; /* Outputs enabled when OE Low */
Pin 11 = PA0
Pin 13 = OE |  | field graphics_mode = [GM1,GM0];
VRAM CPU address 1 ATF16V8
Pin 1 = GM1 | Pin 19 = VA6 | VA6 = (CA7 & !GM1) # (CA6 & GM1);
Pin 2 = CA7 | Pin 18 = VA5 | VA5 = (CA6 & !GM1) # (CA5 & GM1);
Pin 3 = CA6 | Pin 17 = VA4 | VA4 = (CA5 & !GM1) # (CA4 & GM1);
Pin 4 = CA5 | Pin 16 = VA3 | VA3 = (CA4 & !GM1) # (CA3 & GM1);
Pin 5 = CA4 | Pin 15 = VA2 | VA2 = (CA3 & !GM1) # (CA2 & GM1);
Pin 6 = CA3 | Pin 14 = VA1 | VA1 = (CA2 & !GM1) # (CA1 & GM1);
Pin 7 = CA2 | Pin 13 = VA0 | VA0 = (CA1 & !GM1) # (CA0 & GM1);
Pin 8 = CA1 | Pin 12 = NC
Pin 9 = CA0 | Pin 11 = OEN | [VA0..VA6].OE= !OEN;
VRAM CPU address 2 ATF22V10
Pin 1 = PA1 | Pin 23 = VA14 | VA14 = (PA1 & !GM1) # (PA0 & GM1);
Pin 2 = PA0 | Pin 22 = VA13 | VA13 = (PA0 & !GM1) # (CA13 & GM1);
Pin 3 = CA13 | Pin 21 = VA12 | VA12 = (CA13 & !GM1) # (CA12 & GM1);
Pin 4 = CA12 | Pin 20 = VA11 | VA11 = (CA12 & !GM1) # (CA11 & GM1);
Pin 5 = CA11 | Pin 19 = VA10 | VA10 = (CA11 & !GM1) # (CA10 & GM1);
Pin 6 = CA10 | Pin 18 = VA9 | VA9 = (CA10 & !GM1) # (CA9 & GM1);
Pin 7 = CA09 | Pin 17 = VA8 | VA8 = (CA9 & !GM1) # (CA8 & GM1);
Pin 8 = CA08 | Pin 16 = VA7 | VA7 = (CA8 & !GM1) # (CA7 & GM1);
Pin 9 = CA07 | Pin 15 = NC
Pin 10 = GM1 | Pin 14 = NC
Pin 11 = NC
Pin 13 = OE |  | [VA7..VA14].OE= !OEN;
Additional for 256 colour
/DAC_WR
/DAC_RD
/DAC_CE
G2DACLATCH
G2DACOE |  | G1DACEN = (NOTY0 & !MA12 & graphics_mode:2);
G1DACLATCH
G1DACOE |  | G2DACEN = (NOTY0 & MA12 & graphics_mode:2);

Sheet: ORIGINAL PLD
Inputs | Outputs | Rules
NANOCOMPV11.PLD | Nanocomp Address Decoder
Pin 1 = DotClk; | Pin 23 = !Y0VRAM; /* Video RAM Low */ | Y0VRAM = (A15 & !A14) & E;
Pin 2 = RW; | Pin 22 = !Y1RAM; /* RAM /CS */ | Y1RAM = !A15 & E;
Pin 3 = A15; | Pin 21 = !Y2CRAM; /* Video Character RAM */ | Y2CRAM = A15 & A14 & !A13 & !A12 & E;
Pin 4 = A14; | Pin 20 = !Y3CRTC; /* CRTC */ | Y3CRTC = A15 & A14 & !A13 & A12 & !A11 & A10 & E; /* take out A8 and A9 conditions now that 74LS138 is used in place of Y6 */
Pin 5 = A13; | Pin 19 = !Y4PIA1; /* PIA MC6821 /CS */ | Y4PIA1 = A15 & A14 & !A13 & A12 & !A11 & !A10 & !A9 & !A8 & E;
Pin 6 = A12; | Pin 18 = !Y5SERIAL1; /* MC6850 /CS */ | Y5SERIAL1 = A15 & A14 & !A13 & A12 & !A11 & !A10 & A9 & !A8 & E;
Pin 7 = A11; | Pin 17 = Y0VRAMH; /* Video RAM High */ | Y0VRAMH = Y0VRAM;
Pin 8 = A10; | Pin 16 = !Y7ROM; /* ROM /CS */ | Y7ROM = A15 & A14 & A13 & E & RW;
Pin 9 = A9; | Pin 15 = VRAMRW1; /* Video RAM R/W shortened by Q&E */ | VRAMRW1.d = (RW # !Y0VRAMCE);
Pin 10 = A8; | Pin 14 = VRAMRW; /* Video RAM R/W ORd with !Y0VRAMCE */ | VRAMRW.d = VRAMRW1;
Pin 11 = Q;
Pin 13 = E; |  | Y0VRAMCE = (A15 & !A14) & E & Q;
VIDEOLOGIC1V11.PLD | Video Logic 1
Pin 1 = QbClk; | Pin 23 = !G1EN; /* Graphics Latch 1 Enable, sends VRAM data to Shift Reg */ | G1EN = (NOTY0 & !MA12 & graphics_mode:2);
Pin 2 = A0; | Pin 22 = !G2EN; /* Graphics Latch 2 Enable, sends VRAM data to Shift Reg */ | G2EN = (NOTY0 & MA12 & graphics_mode:2);
Pin 3 = MA12; | Pin 21 = DE1; /* Intermediate DE 1 clock delay, not used now */
Pin 4 = GM1; | Pin 20 = !CHRW; /* Character RAM Read/Write control */ | CHRW = ((!VRW & A0 & graphics_mode:0) # (!VRW & !PA1 & graphics_mode:2));
Pin 5 = GM0; | Pin 19 = !CHOE; /* Character RAM Output Enable control */ | CHOE = (((!CHRW # RW) & graphics_mode:0) # ((!(!VRW & !PA1) # (RW & !MA12)) & graphics_mode:2) );
Pin 6 = PA1; | Pin 18 = !CH245CE; /* Character 245 Buffer Chip Enable */ | CH245CE = ((Y0 & A0 & graphics_mode:0) # (Y0 & !PA1 & graphics_mode:2));
Pin 7 = VRW; | Pin 17 = !COOE; /* Colour RAM Output Enable control */ | COOE = (((!CORW # RW) & graphics_mode:0) # ((!(!VRW & PA1) # (RW & MA12)) & COLY3 & graphics_mode:2) );
Pin 8 = RW; | Pin 16 = !CORW; /* Colour RAM Read/Write control */ | CORW = ((!VRW & !A0 & graphics_mode:0) # (!VRW & PA1 & graphics_mode:2));
Pin 9 = NOTY0; | Pin 15 = !CO245CE; /* Colour 245 Buffer Chip Enable */ | CO245CE = ((Y0 & !A0 & graphics_mode:0) # (Y0 & PA1 & graphics_mode:2) # ( !COLY3 & graphics_mode:2));
Pin 10 = Y0; | Pin 14 = DEout; /* DE Inverted and delayed by 4 dot clock delays */ | DEout.d=!DEin;
Pin 11 = DEin;
Pin 13 = COLY3;
VIDEOLOGIC2V9.PLD | Video Logic 2
Pin 1 = DotClk; | Pin 23 = ForeBack; /* Video bit stream for foreground/background */ | ForeBack = Cur2 $ SRDotOut; /* Cursor delayed by 2 Dot Clocks XOR with Shift Register DotOut */
Pin 2 = SRDotOut; | Pin 22 = Cur1; /* Cursor delayed by 1 dot clock */ | Cur1.d = Cursor; /* Map Cursor to input of Cur1 Flip Flop */
Pin 3 = Cursor; | Pin 21 = Cur2; /* Cursor delayed by 2 dot clocks */ | Cur2.d = Cur1; /* Map Cur1 output to input of Cur2 Flip Flop to delay cursor by 2 dot clocks */
Pin 4 = NC0; | Pin 20 = CHLatch; /* Character Latch after 2 dot clock cycles */ | CHLatch=Qc # (!(Qa & Qb));
Pin 5 = NC1; | Pin 19 = Qa; /* Counter output /2 */ | Qa.d = !Qa;
Pin 6 = NC2; | Pin 18 = Qb; /* Counter outut /4 */ | Qb.d = (!Qb & Qa # Qb & !Qa);
Pin 7 = NC3; | Pin 17 = Qc; /* Counter output /8 */ | Qc.d = ((!Qc & Qb & Qa) # (Qc & !(Qb & Qa))) ;
Pin 8 = InvHS; | Pin 16 = SRLatch; /* Original /CLR delayed by 4 dot clock cycles */ | SRLatch= !(Qa & !Qb & Qc);
Pin 9 = InvVS; | Pin 15 = HSout; /* Horizontal Sync, inverted if InvHS is true */ | HSout=HSin&!InvHS # !HSin&InvHS;
Pin 10 = HSin; | Pin 14 = VSout; /* Vertical Sync, inverted if InvVS is true */ | VSout=VSin&!InvVS # !VSin&InvVS;
Pin 11 = VSin;
Pin 13 = NC4;

Sheet: Character MKII
Video RAM 1 | CPU | CRTC | Buffer | Video RAM 2 | CPU | CRTC |  | Character Generator | CPU | CRTC
Character 32K |  |  |  | Colour 32K |  |  |  | RAM 4K
V1A0 | CA1 | MA0 | A0 | V2A0 | CA1 | MA0 |  | CHA0 | CA0 | RA0
V1A1 | CA2 | MA1 | A1 | V2A1 | CA2 | MA1 |  | CHA1 | CA1 | RA1
V1A2 | CA3 | MA2 | A2 | V2A2 | CA3 | MA2 |  | CHA2 | CA2 | RA2
V1A3 | CA4 | MA3 | A3 | V2A3 | CA4 | MA3 |  | CHA3 | CA3 | RA3
V1A4 | CA5 | MA4 | A4 | V2A4 | CA5 | MA4 |  | CHLA4 | CA4 | V1D0
V1A5 | CA6 | MA5 | A5 | V2A5 | CA6 | MA5 |  | CHLA5 | CA5 | V1D1
V1A6 | CA7 | MA6 | A6 | V2A6 | CA7 | MA6 |  | CHLA6 | CA6 | V1D2
V1A7 | CA8 | MA7 | A7 | V2A7 | CA8 | MA7 |  | CHLA7 | CA7 | V1D3
V1A8 | CA9 | MA8 | A0 | V2A8 | CA9 | MA8 |  | CHLA8 | CA8 | V1D4
V1A9 | CA10 | MA9 | A1 | V2A9 | CA10 | MA9 |  | CHLA9 | CA9 | V1D5
V1A10 | CA11 | MA10 | A2 | V2A10 | CA11 | MA10 |  | CHLA10 | CA10 | V1D6
V1A11 | CA12 | MA11 | A3 | V2A11 | CA12 | MA11 |  | CHLA11 | CA11 | V1D7
V1A12 | CA13 | MA12 | A4 | V2A12 | CA13 | MA12 |  | CE | Y2
V1A13 | 0 | 0 | A5 | V2A13 | 0 | 0 |  | R/W | R/W | 1
V1A14 | 0 | 0 | A6 | V2A14 | 0 | 0 |  | CD0 | D0 | SR_A
1/OE (CHOE) | !(CHRW # RW) | !Y0 |  | 2/OE (COOE) | !(CORW # RW) | !Y0 |  | CD1 | D1 | SR_B
CHR/W | !(!VRW & A0) | 1 | A7 | COR/W | !(!VRW & !A0) | 1 |  | CD2 | D2 | SR_C
V1D0 | D0 | CHLA4 |  | V2D0 | D0 | CL0 |  | CD3 | D3 | SR_D
V1D1 | D1 | CHLA5 |  | V2D1 | D1 | CL1 |  | CD4 | D4 | SR_E
V1D2 | D2 | CHLA6 |  | V2D2 | D2 | CL2 |  | CD5 | D5 | SR_F
V1D3 | D3 | CHLA7 |  | V2D3 | D3 | CL3 |  | CD6 | D6 | SR_G
V1D4 | D4 | CHLA8 |  | V2D4 | D4 | CL4 |  | CD7 | D7 | SR_H
V1D5 | D5 | CHLA9 |  | V2D5 | D5 | CL5
V1D6 | D6 | CHAL10 |  | V2D6 | D6 | CL6
V1D7 | D7 | CHAL11 |  | V2D7 | D7 | CL7
VR/W | VideoRAM R/W |  |  |  |  | This is defined in NANOCOMP PLD as CPU R/W combined with VRAM CE Y0 & Q and delayed 2 Dot Clocks
V1A# | Video RAM 1 Address |  |  |  |  | VRAM 1 8K Used in 16K 8000-BFFF 16K RANGE, A13 & A14 wired low
V1D# | Video RAM 1 Data |  |  |  |  | VRAM 2 8K Used in 16K 8000-BFFF 16K RANGE, A13 & A14 wired low
V2A# | Video RAM 2 Address |  |  |  |  | In CPU Address space Colour Byte even, Character Byte Odd interleaved over 16K
V2D# | Video RAM 2 Data |  |  |  |  | CRTC Both VRAM use same MA address, 8K block 102 Lines using CRTC Memory offset
CHLA# | Character Latch RAM Address
CHA# | Character RAM Address
CHD# | Character RAM Data
MA# | CRTC Memory Address
RA# | CRTC Row Address
SR_# | Shift Register Data
CA# | CPU Address
D# | CPU Data
CL# | Colour Latch
 |  |  |  |  | Char RAM | Colour RAM | Ch245 /CE | Co245 /CE
 | CA0 | !CA0 | Y0 | !Y0 | 1/CE | 2/CE |  |  | 1/CE
 | 0 | 1 | 0 | 1 | 1 | 0 | 1 | 0 | 2/CE
 | 0 | 1 | 1 | 0 | 0 | 0 | 1 | 1
 | 1 | 0 | 0 | 1 | 0 | 1 | 0 | 1 | CH1CE= | !CA0 & !Y0
 | 1 | 0 | 1 | 0 | 0 | 0 | 1 | 1 | CO2CE= | CA0 & !Y0
 |  |  |  |  |  |  |  |  | CH245/CE | !(CA0&!Y0) | NAND (CA0,!Y0)
 |  |  |  |  |  |  |  |  | CO245/CE | !(!CA0&!Y0) | OR (CA0,Y0) = NAND(!CA0,!Y0)
 |  |  |  |  |  |  |  |  |  | All Enables are active LOW
 |  |  |  |  |  |  |  |  |  | Character RAM Enabled when Y=1 (CRTC) OR (Y=0 AND CA0=1) CPU Odd address
 |  |  |  |  |  |  |  |  |  | Colour RAM Enabled when Y=1 (CRTC) OR (Y=0 AND CA0=0) CPU Even Address
 |  |  |  |  |  |  |  |  |  | Character 245 Bi Di Buffer only enabled when (Y=0 AND CA0=1) CPU Odd Addresss
 |  |  |  |  |  |  |  |  |  | Colour 245 Bi Di Buffer only enabled when (Y=0 AND CA0=0) CPU Even Addresss
 |  |  |  |  |  |  |  |  |  | Alternatively Character RAM disabled for CPU Even addresses
 |  |  |  |  |  |  |  |  |  | Colour RAM disabled for CPU Odd Addresses
 |  |  |  |  |  |  |  |  |  | Character 245 disabled for CRTC and CPU Even addresses
 |  |  |  |  |  |  |  |  |  | Colour 245 disabled for CRTC and CPU Odd addresses

Sheet: Charactrer MKII Timing
Description | VR/W | /VR/W | CPU A0 | /CPU A0 | VRAM# R/W | Note VRW already ORed Y0 with R/W
Read/Write Character RAM VRAM #1 | 0 | 1 | 0 | 1 | 1 | VRW OR !A0 | Or !VRW NAND A0
 | 0 | 1 | 1 | 0 | 0
 | 1 | 0 | 0 | 1 | 1
 | 1 | 0 | 1 | 0 | 1
Read/Write Colour RAM VRAM #2 | 0 | 1 | 0 | 1 | 0 | VRW OR A0 | Or !VRW NAND !A0 | NAND | 0 | 0 | 1
 | 0 | 1 | 1 | 0 | 1 |  |  |  | 0 | 1 | 1
 | 1 | 0 | 0 | 1 | 1 |  |  |  | 1 | 0 | 1
 | 1 | 0 | 1 | 0 | 1 |  |  |  | 1 | 1 | 0
Also VRAM /OE needs to be high during writes so Bi Di Buffer and VRAM don't clash
 | CH245/CE | CPU R/W | CH VRAM /OE
Character VRAM | 0 | 0 | 1 |  | NOR (CH245/CE, CPU R/W)
 | 0 | 1 | 0
 | 1 | 0 | 0
 | 1 | 1 | 0
 | CO245/CE | CPU R/W | CO VRAM /OE
Colour VRAM | 0 | 0 | 1 |  | NOR (CO245/CE, CPU R/W)
 | 0 | 1 | 0
 | 1 | 0 | 0
 | 1 | 1 | 0

Sheet: 640x480 Pixel Map
Pixel Row | 16K Page | Column | 0-7 | 8-15 | 16-23 | 24-31 | 32-39 | 40-47 | … | 624-631 | 632-639
0 | 00 |  | 8000 | 8008 | 8010 | 8018 | 8020 | 8028 | … | 8270 | 8278 | 8 Pixel rows = 640 Bytes 0x280
1 | 00 |  | 8001 | 8009 | 8011 | 8019 | 8021 | 8029 | … | 8271 | 8279
2 | 00 |  | 8002 | 800A | 8012 | 801A | 8022 | 802A | … | 8272 | 827A
3 | 00 |  | 8003 | 800B | 8013 | 801B | 8023 | 802B | … | 8273 | 827B
4 | 00 |  | 8004 | 800C | 8014 | 801C | 8024 | 802C | … | 8274 | 827C
5 | 00 |  | 8005 | 800D | 8015 | 801D | 8025 | 802D | … | 8275 | 827D
6 | 00 |  | 8006 | 800E | 8016 | 801E | 8026 | 802E | … | 8276 | 827E
7 | 00 |  | 8007 | 800F | 8017 | 801F | 8027 | 802F | … | 8277 | 827F
8 | 00 |  | 8280 | 8288 | 8290 | 8298 | 82A0 | 82A8 | … | 84F0 | 84F8
9 | 00 |  | 8281 | 8289 | 8291 | 8299 | 82A1 | 82A9 | … | 84F1 | 84F9
10 | 00 |  | 8282 | 8290 | 8292 | 8300 | 82A2 | 82A10 | … | 84F2 | 84FA
11 | 00 |  | 8283 | 8291 | 8293 | 8301 | 82A3 | 82A11 | … | 84F3 | 84FB
12 | 00 |  | 8284 | 8292 | 8294 | 8302 | 82A4 | 82A12 | … | 84F4 | 84FC
13 | 00 |  | 8285 | 8293 | 8295 | 8303 | 82A5 | 82A13 | … | 84F5 | 84FD
14 | 00 |  | 8286 | 8294 | 8296 | 8304 | 82A6 | 82A14 | … | 84F6 | 84FE
15 | 00 |  | 8287 | 8295 | 8297 | 8305 | 82A7 | 82A15 | … | 84F7 | 84FF
… | 00 |  | 8500… |  |  |  | 48 | 49
 |  |  |  |  |  |  | 376-384 | 385-393
200 | 00/01 |  | BE80 | BE88 | BE90 | BE98 | BFF8 | 8000 |  | 80F0 | 80F8
201 | 00/01 |  | BE81 | BE89 | BE91 | BE99 | BFF9 | 8001 |  | 80F1 | 80F9
202 | 00/01 |  | BE82 | BE8A | BE92 | BE9A | BFFA | 8002 |  | 80F2 | 80FA
203 | 00/01 |  | BE83 | BE8B | BE93 | BE9B | BFFB | 8003 |  | 80F3 | 80FB
204 | 00/01 |  | BE84 | BE8C | BE94 | BE9C | BFFC | 8004 | … | 80F4 | 80FC
205 | 00/01 |  | BE85 | BE8D | BE95 | BE9D | BFFD | 8005 | … | 80F5 | 80FD
206 | 00/01 |  | BE86 | BE8E | BE96 | BE9E | BFFE | 8006 | … | 80F6 | 80FE
207 | 00/01 |  | BE87 | BE8F | BE97 | BE9F | BFFF | 8007 | … | 80F7 | 80FF
…
208 | 01 |  | 8100 | 8108 | 8110 | 8118 | …
 |  |  |  |  |  |  | 16 | 17
 |  |  |  |  |  |  | 120-128 | 129-137
408 | 01/10 |  | BF80 | BF88 | BFA0 | BFA8 | BFF8 | 8000 | … | 81F0 | 81F8
409 | 01/10 |  | BF81 | BF89 | BFA1 | BFA9 | BFF9 | 8001 | … | 81F1 | 81F9
410 | 01/10 |  | BF82 | BF9A | BFA2 | BFAA | BFFA | 8002 | … | 81F2 | 81FA
411 | 01/10 |  | BF83 | BF9B | BFA3 | BFAB | BFFB | 8003 | … | 81F3 | 81FB
412 | 01/10 |  | BF84 | BF9C | BFA4 | BFAC | BFFC | 8004 |  | 81F4 | 81FC
413 | 01/10 |  | BF85 | BF9D | BFA5 | BFAD | BFFD | 8005 |  | 81F5 | 81FD
414 | 01/10 |  | BF86 | BF9E | BFA6 | BFAE | BFFE | 8006 |  | 81F6 | 81FE
415 | 01/10 |  | BF87 | BF9F | BFA7 | BFAF | BFFF | 8007 |  | 81F7 | 81FF
416 | 10 |  | 8200 | 8208 | 8210 | 8218 | …
…
472 | 10 |  | 9380 | 9388 | 94F0 | 94F8 | 9500 | 9508 |  | 96F0 | 95F8
473 | 10 |  | 9381 | 9389 | 94F1 | 94F9 | 9501 | 9509 |  | 95F1 | 95F9
474 | 10 |  | 9382 | 938A | 94F2 | 94FA | 9502 | 950A |  | 95F2 | 95FA
475 | 10 |  | 9383 | 938B | 94F3 | 94FB | 9503 | 950B |  | 95F3 | 95FB
476 | 10 |  | 9384 | 938C | 94F4 | 94FC | 9504 | 950C |  | 95F4 | 95FC
477 | 10 |  | 9385 | 938D | 94F5 | 94FD | 9505 | 950D |  | 95F5 | 95FD
478 | 10 |  | 9386 | 938E | 94F6 | 94FE | 9506 | 950E |  | 95F6 | 95FE
479 | 10 |  | 9387 | 938F | 94F7 | 94FF | 9507 | 950F |  | 95F7 | 95FF
480 |  |  | 9600

Sheet: Graphics 320x200 x 256C & MDA
Video RAM 1 | CPU | CRTC | Video RAM 2 | CPU | CRTC |  | Character Cell 0 |  |  |  |  | Character Cell 1
Graphics1 |  |  | Graphics2 |  |  |  | Pixel | 0 | 1 | 2 | 3 |  | 0 | 1 | 2 | 3
V1A0 | CA0 | Qb | V2A0 | CA0 | Qb | RA1 |  | 0 | 0 | 0 | 0 |  | 0 | 0 | 0 | 0
V1A1 | CA1 | Qc | V2A1 | CA1 | Qc | DotClk/4 | Qb | 0 | 1 | 0 | 1 |  | 0 | 1 | 0 | 1
V1A2 | CA2 | RA1 | V2A2 | CA2 | RA1 | DotClk/8 | Qc | 0 | 0 | 1 | 1 |  | 0 | 0 | 1 | 1
V1A3 | CA3 | MA0 | V2A3 | CA3 | MA0
V1A4 | CA4 | MA1 | V2A4 | CA4 | MA1 | RA1 |  | 1 | 1 | 1 | 1 |  | 1 | 1 | 1 | 1
V1A5 | CA5 | MA2 | V2A5 | CA5 | MA2 | DotClk/4 | Qb | 0 | 1 | 0 | 1 |  | 0 | 1 | 0 | 1
V1A6 | CA6 | MA3 | V2A6 | CA6 | MA3 | DotClk/8 | Qc | 0 | 0 | 1 | 1 |  | 0 | 0 | 1 | 1
V1A7 | CA7 | MA4 | V2A7 | CA7 | MA4
V1A8 | CA8 | MA5 | V2A8 | CA8 | MA5 | 6845 CRTC Configuration 80 Characters & 100 Character Rows, 4 Raster Lines per Row
V1A9 | CA9 | MA6 | V2A9 | CA9 | MA6 |  | Same timing as 70 Hz 80x25 Character Mode
V1A10 | CA10 | MA7 | V2A10 | CA10 | MA7
V1A11 | CA11 | MA8 | V2A11 | CA11 | MA8 |  | Width 80 Characters x 4 pixels, 320 Pixels x 8 Bits, 256 Colours
V1A12 | CA12 | MA9 | V2A12 | CA12 | MA9 |  | Height 400 lines, ignore RA0 double scan, 200 lines, 100 Character Row
V1A13 | CA13 | MA10 | V2A13 | CA13 | MA10 | Clock Cycle | 0 | 0 | 1 | 1 | 2 | 2 | 3 | 3 | 4 | 4 | 5 | 5 | 6 | 6 | 7 | 7
V1A14 | PA0 | MA11 | V2A14 | PA0 | MA11 | Dot Clock | 1 | 0 | 1 | 0 | 1 | 0 | 1 | 0 | 1 | 0 | 1 | 0 | 1 | 0 | 1 | 0
1/CE | PA1=0 | MA12=0 | 2/CE | PA1=1 | MA12=1 | Qa | 0 | 0 | 1 | 1 | 0 | 0 | 1 | 1 | 0 | 0 | 1 | 1 | 0 | 0 | 1 | 1
R/W | R/W | 1 | R/W | R/W | 1 | Qb | 0 | 0 | 0 | 0 | 1 | 1 | 1 | 1 | 0 | 0 | 0 | 0 | 1 | 1 | 1 | 1
V1D0 | D0 | DAC0 | V2D0 | D0 | DAC0 | Qc | 0 | 0 | 0 | 0 | 0 | 0 | 0 | 0 | 1 | 1 | 1 | 1 | 1 | 1 | 1 | 1
V1D1 | D1 | DAC1 | V2D1 | D1 | DAC1 | CHLatch=Qc # (!(Qa & Qb)); | 1 | 1 | 1 | 1 | 1 | 1 | 0 | 0 | 1 | 1 | 1 | 1 | 1 | 1 | 1 | 1
V1D2 | D2 | DAC2 | V2D2 | D2 | DAC2 | SRLatch= !(Qa & !Qb & Qc); | 1 | 1 | 1 | 1 | 1 | 1 | 1 | 1 | 0 | 0 | 1 | 1 | 1 | 1 | 1 | 1
V1D3 | D3 | DAC3 | V2D3 | D3 | DAC3 | !Qa | 1 | 1 | 0 | 0 | 1 | 1 | 0 | 0 | 1 | 1 | 0 | 0 | 1 | 1 | 0 | 0
V1D4 | D4 | DAC4 | V2D4 | D4 | DAC4
V1D5 | D5 | DAC5 | V2D5 | D5 | DAC5 | G1/2 Latch=!(DC&Qa) | 1 | 1 | 0 | 1 | 1 | 0 | 1 | 1 | 1 | 0 | 1 | 1 | 1 | 0 | 1 | 1
V1D6 | D6 | DAC6 | V2D6 | D6 | DAC6 | ~~G1/2 Latch=(DC&!Qa)~~ | 0 | 1 | 0 | 0 | 0 | 1 | 1 | 0 | 1 | 1 | 1 | 0 | 1 | 1 | 1 | 0
V1D7 | D7 | DAC7 | V2D7 | D7 | DAC7
 |  |  |  |  |  | Latch triggered on 0 to 1 edge
V1A# | Video RAM 1 Address |  |  |  | VRAM 1 8K Used in 16K 8000-BFFF 16K RANGE, A13 & A14 wired low |  |  |  |  |  |  | CH Latch for MDA |  | CHLatch=Qc # Qa # Qb;
V1D# | Video RAM 1 Data |  |  |  | VRAM 2 8K Used in 16K 8000-BFFF 16K RANGE, A13 & A14 wired low |  |  |  |  |  |  | ATSRLatch for MDA |  | ATSR=Qc # (!(Qa & Qb));
V2A# | Video RAM 2 Address |  |  |  | In CPU Address space Colour Byte even, Character Byte Odd interleaved over 16K |  |  |  |  |  |  | ATSRLatch for MDA |  | ATSR=!Qc # Qa # Qb;
V2D# | Video RAM 2 Data |  |  |  | CRTC Both VRAM use same MA address, 8K block 102 Lines using Memory offset
CHA# | Character RAM Address
CHD# | Character RAM Data |  |  |  | CRTC 80 Cols X 100 Rows x 2 Lines Per Char, 4 bytes per character using Qb, Qc
MA# | CRTC Memory Address |  |  |  | Double scan, ignore RA0 so get 2 lines per pixel, 4 Rows per char
RA# | CRTC Row Address |  |  |  |  |  | Result | gm=0 | /CHLatch | gm=2 | /Y3COLL | gm=3 | /(!DotClk&Qa) |  |  | Latches active low to high edge (LOW)
SR_# | Shift Register Data |  |  |  |  | (!gm:0 # CHLatch) & | 1 | 0 | 1 | 0 | 1 | 0 | 1
CA# | CPU Address |  |  |  |  |  | 1 | 1 | 1 | 0 | 1 | 0 | 1
D# | CPU Data |  |  |  |  |  | 1 | 0 | 0
CL# | Colour Latch |  |  |  |  |  | 0 | 1 | 0
PA# | Page Address |  |  |  |  | (!gm:2 # /Y3COLL) & | 1 |  |  | 0 | 0
Qb | 6MHz H/L Nibble select |  |  |  |  |  | 1 |  |  | 0 | 1
Qc | Character Clock, High/Low every CRTC Clock |  |  |  |  |  | 1 |  |  | 1 | 1
 |  |  |  |  |  |  | 0 |  |  | 1 | 0
 |  |  |  |  |  | (!gm:3 # (!DotClk&Qa)) & | 1 |  |  |  |  | 0 | 0
 |  |  |  |  |  |  | 1 |  |  |  |  | 0 | 1
 |  |  |  |  |  |  | 1 |  |  |  |  | 1 | 1
 |  |  |  |  |  |  | 0 |  |  |  |  | 1 | 0

Sheet: 320x200 Pixel Map
 |  | Char | 0 | 1 | 2 | 3 | 4 | 5 |  | 78 | 79
Pixel Row | 16K Page | Column | 0-3 | 4-7 | 8-11 | 12-15 | 16-19 | 20-23 | … | 312-315 | 316-319
0 | 00 |  | 8000 | 8008 | 8010 | 8018 | 8020 | 8028 | … | 8270 | 8278 |  | 2 Pixel rows = 640 Bytes 0x280
1 | 00 |  | 8004 | 800C | 8014 | 801C | 8024 | 802C | … | 8274 | 827C | 827F
2 | 00 |  | 8280 | 8288 | 8290 | 8298 | 82A0 | 82A8 | … | 84F0 | 84F8
3 | 00 |  | 8284 | 828C | 8294 | 829C | 82A4 | 82AC | … | 84F4 | 84FC | 84FF
4 | 00 |  | 8500 | 8508 | 8510 | 8518 | 8520 | 8528 | … | 8770 | 8778
5 | 00 |  | 8504 | 850C | 8514 | 851C | 8524 | 852C | … | 8774 | 877C
6 | 00 |  | 8780 | 8788 | 8790 | 8798 | 87A0 | 87A8 | … | 89F0 | 89F8
7 | 00 |  | 8784 | 878C | 8794 | 879C | 87A4 | 87AC | … | 89F4 | 89FC
8 | 00 |  | 8A00 | 8A08 | 8A10 | 8A18 | 8A20 | 8A28 | … | 8C70 | 8C78
9 | 00 |  | 8A04 | 8A0C | 8A14 | 8A1C | 8A24 | 8A2C | … | 8C74 | 8C7C
10 | 00 |  | 8C80 | 8C88 | 8C90 | 8C98 | 8CA0 | 8CA8 | … | 8EF0 | 8EF8
11 | 00 |  | 8C84 | 8C8C | 8C94 | 8C9C | 8CA4 | 8CAC | … | 8EF4 | 8EFC
12 | 00 |  | 8F00 | 8F08 | 8F10 | 8F18 | 8F20 | 8F28 | … | 9170 | 9178
13 | 00 |  | 8F04 | 8F0C | 8F14 | 8F1C | 8F24 | 8F2C | … | 9174 | 917C
14 | 00 |  | 9180 | 9188 | 9190 | 9198 | 91A0 | 91A8 | … | 93F0 | 93F8
15 | 00 |  | 9184 | 918C | 9194 | 919C | 91A4 | 91AC | … | 93F4 | 93FC | 93FF
… | 00 |  | 9400 |  |  |  |  | 48 | 49
 |  |  |  |  |  |  |  | 192-195 | 196-199
50 | 00/01 |  | BE80 | BE88 | BE90 | BE98 | BEA0 | BEF8 | 8000 | 8008 | 8070
51 | 00/01 |  | BE84 | BE8C | BE94 | BE9C | BEA4 | BEFC | 8004 | 800C | 8074 | 8077
52 | 01 |  | 8078 | 8080 | 8088 | 8090 | 8098 | 8100 |  | 80F2 | 82F0
54 | 01 |  | 807C | 8084 | 808C | 8094 | 809C | 8114 |  | 80F3 | 82F4 | 82F7
…
