breadboardinglabs/Breadboard8088PC/Docs/BreadboardPC_IRQ_and_IO.xlsx

Sheet: Interrupts
Interrupt | Description | Comments
NMI | Parity | Not used/Nanocomp Monitor Abort
IRQ0 | Timer | Intel 8253 Programmable Timer
IRQ1 | Keyboard | VIA82C42 Keyboard Controller
IRQ2 | Interrupt C.#2 | Cascade for Interrupt Controller #2
IRQ3 | Serial #2
IRQ4 | Serial #1
IRQ5 | Parallel #2 | PC-XT used this for Fixed Disk
IRQ6 | Diskette C.
IRQ7 | Parallel #1
IRQ8 | Real Time Clock | PC-AT Onwards RTC
IRQ9 | Expansion Bus
IRQ10 | Expansion Bus
IRQ11 | Expansion Bus
IRQ12 | Mouse | VIA82C42 Mouse
IRQ13 | Maths Co. Proc. | 8087 Maths Co Processor
IRQ14 | Fixed Disk C. | PC-XT used IRQ5
IRQ15 | Expansion Bus

Sheet: IO Ports
I/O Port No. | Description | Comments | Chip Select Name | IOA19A12
0x00-0x1F | DMA Controller #1 |  | DMACS
0x20-0x3F | Interupt Controller #1 |  | PIC1CS
0x40-0x43 | Interval Timer #1 |  | TCCS (PITCS)
0x60-0x63 | PPI Port A, B, C & Control | Only Port B required 61 | PPICS (PORTBR,PORTBW)
0x60, 0x64 | Keyboard Controller | Chip A0 mapped to A2 | KEYCS
0X70,0X71 | Realtime Clock |  | RTCCS (RTCALE,RTCR,RTCW)
0x80-0x83 | DMA Page Register | Only 81, 82 & 83 used | WRTOMAPREG (DMAPGW)
0x80 | Power On Self Test (POST) | Same as DMA Page Reg 00. | POSTCS
0xA0-0xBF | Interupt Controller #2 |  | PIC2CS
0xC0-0xDF | DMA Controller #2 | Not used in XT only 16bit+
0x1F0-0x1F8 | Fixed Disk Controller | PC-XT used 0x320-0x32F, next phase
0x2F8-0x2FF | Parallel Port #2
0x2F8-0x2FE | Serial Port #2
0x378-0x37F | Parallel Port #1
0x3B0-0x3BF | Monochome Display Adapter MDA | Already implemented | 6845CS, CRTC,CRTS
0x3D0-0x3DF | Colour Graphics Adaptor CGA | Next Phase
0x3F0-0x3F7 | Diskette Controller |  | FDIO (FDCS, FDLDOR,FDLDCR)
0x3F8-0x3FE | Serial Port #1 | Next Phase
0xD000-0xD003 | PIA Controller Keypad & LED Display | Nanocomp compatible PIA | PIACE
0xE000-0xE001 | MC6850 Serial Controller | Nanocomp compatible COM port | COM0CE

Sheet: DMA CLock
 |  |  |  |  |  | RST
 | 0 |  | 1 |  | 2 |  | 3 |  | 4 |  | 5 |  | 6 |  | 7
Osc14 | 0 | 1 | 0 | 1 | 0 | 1 | 0 | 1 | 0 | 1 | 0 | 1 | 0 | 1 | 0 | 1
Qa | 0 | 0 | 1 | 1 | 0 | 0 | 1 | 1 | 0 | 0 | 1 | 1 | 0 | 0 | 1 | 1
Qb | 0 | 0 | 0 | 0 | 1 | 1 | 1 | 1 | 0 | 0 | 0 | 0 | 1 | 1 | 1 | 1
Qc | 0 | 0 | 0 | 0 | 0 | 0 | 0 | 0 | 1 | 1 | 1 | 1 | 1 | 1 | 1 | 1
Divide3 | 0 | 0 | 0 | 1 | 1 | 1 | 0 | 0 | 0 | 1 | 1 | 1 | 0 | 0 | 0
CLK88 | 0 | 0 | 1 | 1 | 1 | 1 | 0 | 0 | 1 | 1 | 1 | 1 | 0 | 0
RST | !Qa & Qb & Osc14
Divide3 | (Osc14 & Qa) # Qb
CLK88 | Qa # Qb

Sheet: Port B
Read Bit | Name (XI8088) | Description | Write Bit | Name | Description
D0 | TIME2GATESPK (GATE2) | Used to turn Timer Ch 2 on for sound | D0 | TIME2GATESPK (GATE2)
D1 | SPKRDATA (SPKR) | Output bit for sound directly | D1 | SPKRDATA (SPKR)
D2 | (TURBO) | XI 8088 Turn on Turbo clock | D2 | (TURBO)
D3 | (ENIOCHK) | Enable IO Check Status | D3 | ENIOCHK | Enable IOCHK generaton of NMI
D4 | OUT1 (REFRESH_DET) | OUT1 from DRAM Refresh Clock | D4 |  | Needs D Flip Flop to toggle on OUT1 low to high
D5 | OUT2 | OUT2 from Timer Ch 2 | D5
D6 | IOCHK NMI STATUS | Will NMI be reported for IOCHK | D6
D7 | GND | N/A | D7

Sheet: Floppy Disk
Pin number | Abbreviation | Description | Notes | Type
2 | DENSEL | Density Select 1=Low/0=High | The default use is 0 | Output
4 | RSVD | Reserved | No connection or connect to the ground
6 | RSVD | Reserved | No connection or connect to the ground
8 | INDEX# | Index | 0=Index Input
10 | MOTEA# | Motor A Enable | 0=Motor Enable Drive 0 | Output
12 | DRVSB | Drive Select B |  | Output
14 | DRVSA | Drive Select A |  | Output
16 | MOTEB# | Motor B Enable | 0=Motor Enable Drive 1 | Output
18 | DIR# | Direction Select | Low Current/Direction in uPD765 controller | Output
20 | STEP# | Head Step Fault Reset/Step in uPD765 controller Output
22 | WDATA | Write Data |  | Output
24 | WGATE# | Floppy Write Enable | 0=Write Gate | Output
26 | TRK0# | Track 0 | Fault/Track 0 in uPD765 controller | Input
28 | WPT# | Write Protect | 0=Write Protect | Input
30 | RDATA | Read Data |  | Input
32 | HDSEL#/SIDE | Head Select / Side select | Two uses | see application or use for details.(Side select:1=Side 0/0=Side 1) | Output
34 | DSKCHG# | Disk Change | 1=Disk Change/0=Ready | Input
3 | RSVD | Reserved | No connection or connect to the ground
5 | N/C | No connection Pins usually do not exist here to prevent the male plug from being inserted in the opposite direction
Odd pins 1 thru 33 GND Ground Except for the 3rd and 5th pins Power
