breadboardinglabs/Breadboard8088PC/Kicad/Nanocomp8088V3/Nanocomp8088V3.pdf

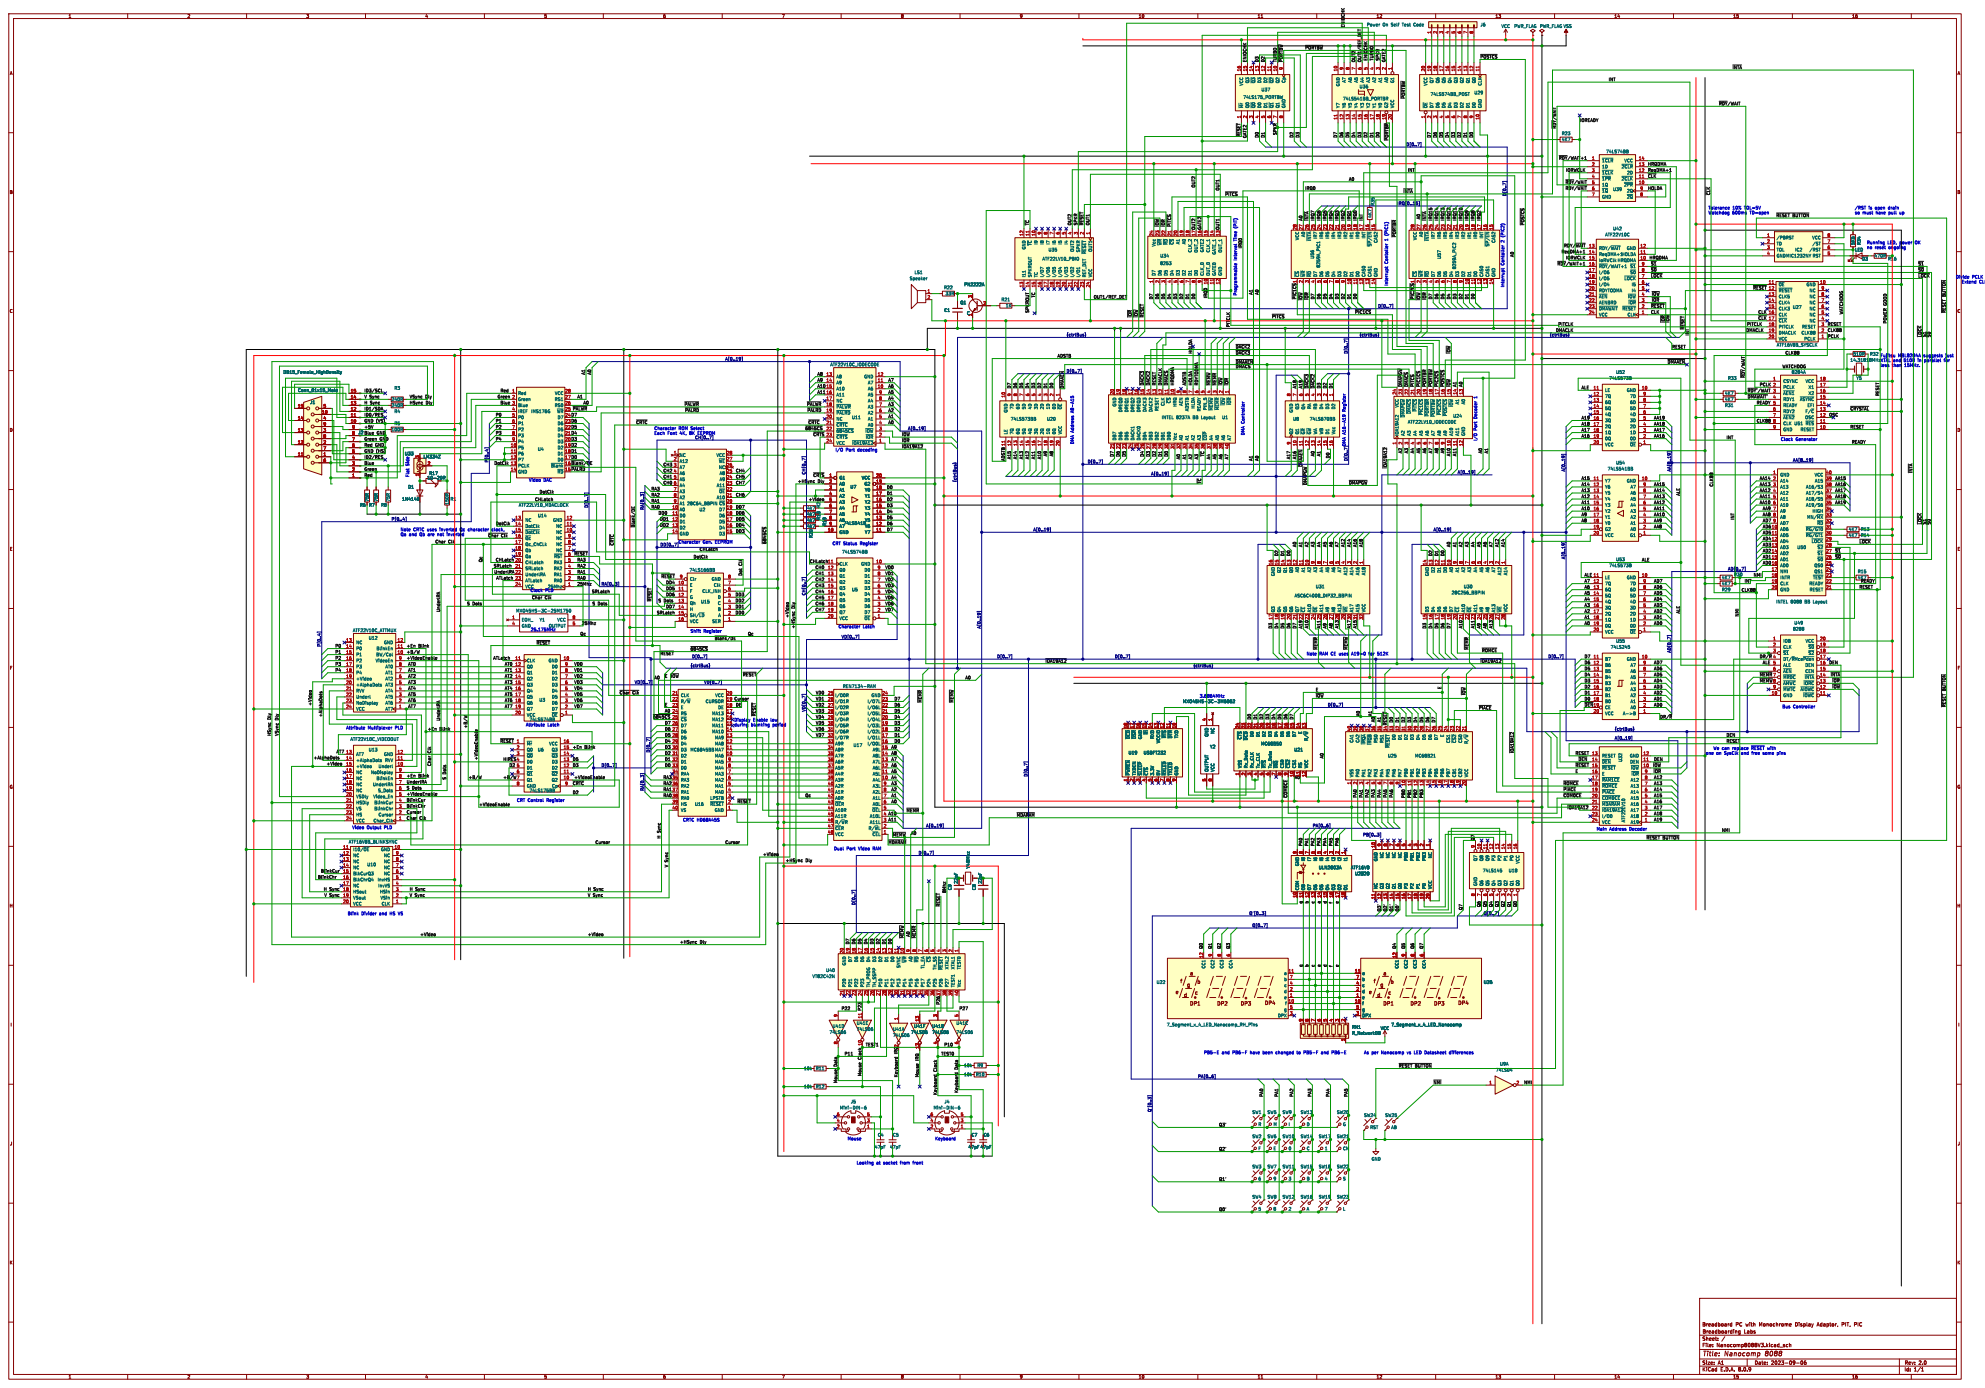
[picture p2: page 1]

8 Power On Self Test Code J6

d ~{INTA} ~{RESET BUTTON} PA4 PA5 A[0..19] UnderlRA +B/W

Tolerance 10% TOL=5V Watchdog 600ms TD=open

/RST is open drain
so must have pull up

1 I9 10 ~{TC}11 GND 12 I11 13 SPKROUT 14 TC 15 I/O7 16 I/O6 17 I/O5 18 I/O4 19 ~{RESET}2 I/O3 20 I/O2 21 I/O1 22 REF_DET 23 VCC 24 SPKR
LS1 Speaker 10 11 U41E

2 A1 20 ~{CS}21 ~{RD}22 ~{WR}23 Vcc 24 D5

Running LED, power OK
no reset ongoing
LED

Divide PCLK by 2 for 1.19Mhz PIT Clock Extend CLK88 Duty Cycle to 50/50 Clock Generator
10 VCC

less than 15MHz. DMA A16-A19 Register

1 Q1 10 ~{GR} 11 ~{GW} 12 WA 13 WB 14 D1 15 Vcc 16 D3

1 A10 10 A11 11 GND 12 A0 13 A1 14 ~{IOW}15 ~{POSTCS}16 ~{PIC2CS}17 ~{PORTBW}18 ~{PORTBR}19 A2

2 ~{PIC1CS}20 ~{PITCS}21 ~{DMACS}22 ~{DMAPGW}23 VCC 24 A3

CRT Status Register Dual Port Video RAM

9 U28 ATF16V8 R184k7 R2 4k7 GND 1 MA6 10 MA7 11 MA8 12 MA9 13 MA10 14 MA11 15 MA12 16 MA13 17 DE 18 CURSOR 19 ~{RESET}2 VCC 20 CLK 21 R/~{W} 22 E

2 ~{CE} 20 A10 21 ~{OE} 22 A11 23 A9 24 A8 25 A13 26 ~{WE} 27 VCC 28 A7

RESET
We can replace ~{RESET}with

one on SysClk and free some pins CRT Control Register
HIRES

Looking at socket from front
