breadboardinglabs/Breadboard8088PC/Kicad/Nanocomp8088V1/Nanocomp8088V1.pdf

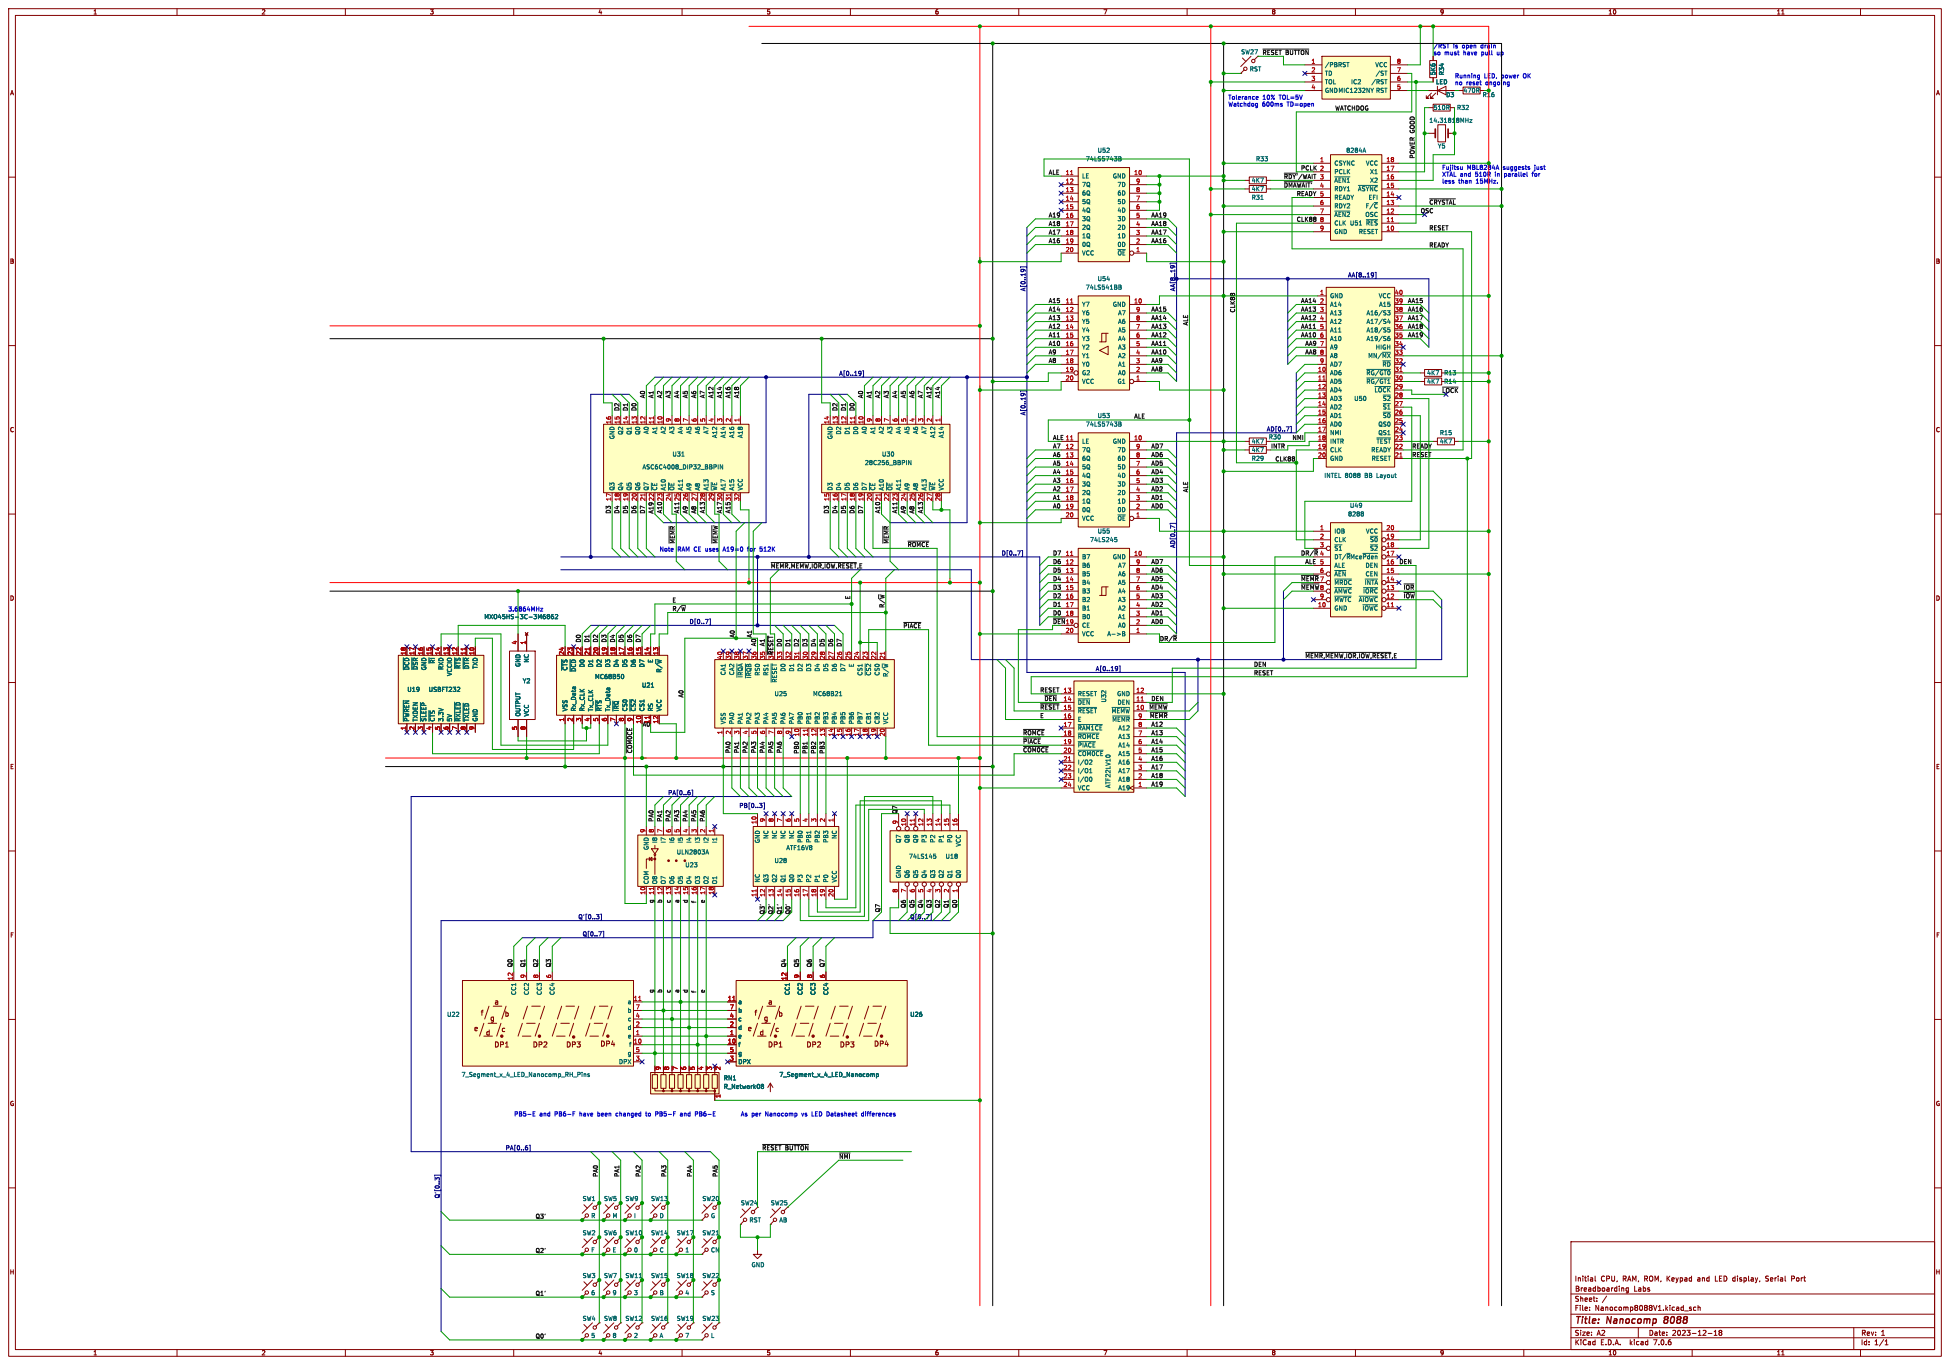
[picture p3: page 1]

/RST is open drain
so must have pull up

Tolerance 10% TOL=5V Watchdog 600ms TD=open

Note RAM CE uses A19=0 for 512K

~{MEMR,MEMW,IOR,IOW,RESET},E
