breadboardinglabs/Breadboard8088PC/Kicad/Nanocomp8088V3/Nanocomp8088V3.kicad_pcb

## KiCad design docs/kicad/flower-pot-schematic.kicad_sch


Parts:
D1, D2, D3, D4: LED
J1: Raspberry_Pi_2_3
K1: SRD-05VDC-SL-C; Relay_SPDT_SANYOU_SRD_Series_Form_C
M1: Motor_DC
R1: 10K
R2: 220R
R3: R_Photo
SW1: SW_Push
U1: MCP3202
U2: DHT11; Aosong_DHT11_5.5x12.0_P2.54mm
U3: keyestudio_Ks0049

Connections:
unnamed: D1.1 (K), D2.1 (K), D3.1 (K), D4.1 (K), R2.1, U2.4 (GND)
unnamed: D1.2 (A), J1.36 (GPIO16)
unnamed: D2.2 (A), J1.38 (GPIO20/MOSI1)
unnamed: D3.2 (A), J1.40 (GPIO21/SCLK1)
unnamed: D4.2 (A), J1.37 (GPIO26)
unnamed: J1.1 (3V3), J1.17 (3V3)
unnamed: J1.2 (5V), J1.4 (5V)
unnamed: J1.11 (GPIO17), K1.5
unnamed: J1.13 (GPIO27), SW1.2
unnamed: J1.6 (GND), J1.9 (GND), J1.14 (GND), J1.20 (GND), J1.25 (GND), J1.30 (GND), J1.34 (GND), J1.39 (GND)
unnamed: J1.16 (GPIO23), U2.2 (IO)
unnamed: J1.19 (MOSI0/GPIO10), U1.5 (DIN)
unnamed: J1.21 (MISO0/GPIO9), U1.6 (DOUT)
unnamed: J1.23 (SCLK0/GPIO11), U1.7 (CLK)
unnamed: J1.24 (~CE0/GPIO8), U1.1 (~CS/SHDN)
unnamed: K1.2, M1.2 (-)
unnamed: K1.3, M1.1 (+)
unnamed: R1.1, R3.2, U1.2 (CH0), U3.
unnamed: R2.2, SW1.1
unnamed: R3.1, U3.
unnamed: U1.3 (CH1), U3.
