breadboardinglabs/Breadboard8088PC/(commit log)

2023-12-18 Initial Breadboard PC Drop up to video #7
    Initial drop of Datasheets and files referenced up to BB PC Video #7
    [Nanocomp8088V1.kicad_pcb, Nanocomp8088V1.kicad_sch]
2024-03-16 Check in for BBPC V2.0 with MDA Video, PIT, PIC
    Check in for BBPC V2.0 with MDA Video, PIT, PIC
    KiCad diagrams now use KiCad 8.0
    [6809_to_8086.xlsx, BreadboardPC_IRQ_and_IO.xlsx, MDA_PLD_Design.xlsx, MappingDA_Combined_Snowv2_MDA_Corrections.xlsx, Nanocomp8088V2.kicad_pcb, Nanocomp8088V2.kicad_sch]
2025-01-26 BIOS changes for BBPC and FDC PIO
    Breadboard PC changes and corrections and Programmed IO Changes to remove DMA from Floppy Disk accesses
    Changes in setloc to allow BIOS to fit.
    bios.asm Extra POST writes for FDC debug, additional lines for Nanocomp monitor, BBPC VGA Palette init, model_sub_byte added for MS PS/2 driver, extend ROM scan to look for XT-IDE BIOS at F8000
    Config.inc has Breadboard PC Configuration added, default floppies A 1.44MB only
    floppy1.inc Changes to remove DMA and add PIO, POST debug messages, Note Disk Change overridden due to DIP WD37C65C, DMA code commented out
    fdc_wait_irq replaced with chk_stat_results or c, hk_stat_2 from PCJr BIOS, extra comments added, set_f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
    [bios.asm]
2025-03-03 Upload of Breadboard PC Version 1 files
    Remaining files for Breadboard PC version 1. Includes KiCad schematic V3 for the BBPC Version 1
    [MappingDA_Combined_CGA.xlsx, Nanocomp8088V3.kicad_pcb, Nanocomp8088V3.kicad_sch]
